Titaniumthunder/MAC-Attack/docs/README.md

# docs

| Item | What it is |
|---|---|
| `Model/` | **Everything about the machine-learning model**, numbered in the order it happened. Start with `Model/README.md` (reading order and the story from 01 onward); the current model is `13_modelV2_bearing_status_and_health.pdf`, and `14_modelV2_review_session.pdf` reviews it |
| `Machine_Guardian_Project_Brief.pdf` | the original project proposal |
| `log.md` | the project log: decisions, hardware builds and board tests, in order |
| `systolic_dataflow.html` | animated view of data moving through the 8 × 8 systolic array |
