Titaniumthunder/MAC-Attack/Alex/README.md

# Alex

Owner of:
- RTL / architecture
- Board bring-up (ZedBoard)
- Chip interface spec
- Board results

Put personal notes, scratch work and results here. Shared source goes in the design folders,
`mac_attack_accel/` (design 1) and `mac_attack_accel_MLP/` (design 2). The step 14 staging files that were in
`Alex/step14/` are in `archive/Alex/step14/`.
