Titaniumthunder/MAC-Attack/James/README.md

# James

Owner of:
- Verification (Python golden model)
- ML track (DCASE data, training, INT8/INT4 quantization)
- Equation proofs

Put personal notes, scratch work and results here. Shared source goes in `mac_attack_accel/`.
Datasets and large weight files go to Google Drive, not git.
