Titaniumthunder/MAC-Attack/Marco/README.md

# Marco

Owner of:
- Physical design (OpenLane / SKY130)
- Fabrication research
- Power measurement

Put personal notes, scratch work and results here. Shared source goes in `mac_attack_accel/`.
