Titaniumthunder/MAC-Attack/mac_attack_accel/zed/mac_zed_project/mac_zed.runs/impl_1/.init_design.begin.rst

<?xml version="1.0"?>
<ProcessHandle Version="1" Minor="0">
    <Process Command=".planAhead." Owner="alexsalamati" Host="ALEXSALAMAT56FC" Pid="10828">
    </Process>
</ProcessHandle>
