Titaniumthunder/MAC-Attack/mac_attack_accel/zed/mac_zed_project/mac_zed.runs/system_auto_pc_0_synth_1/.vivado.begin.rst

<?xml version="1.0"?>
<ProcessHandle Version="1" Minor="0">
    <Process Command="vivado.bat" Owner="User" Host="ALEX" Pid="52168" HostCore="24" HostMemory="033519468544">
    </Process>
</ProcessHandle>
