Titaniumthunder/MAC-Attack/mac_attack_accel/zed/mac_zed_project/mac_zed.runs/system_mac_0_synth_1/.vivado.begin.rst

<?xml version="1.0"?>
<ProcessHandle Version="1" Minor="0">
    <Process Command="vivado.bat" Owner="alexsalamati" Host="ALEXSALAMAT56FC" Pid="5024" HostCore="16" HostMemory="034353119232">
    </Process>
</ProcessHandle>
