Titaniumthunder/MAC-Attack/mac_attack_accel_MLP/zed/mac_zed_project/mac_zed.runs/impl_1/.vivado.begin.rst

<?xml version="1.0"?>
<ProcessHandle Version="1" Minor="0">
    <Process Command="vivado.bat" Owner="alexsalamati" Host="ALEXSALAMAT56FC" Pid="1852" HostCore="16" HostMemory="034353119232">
    </Process>
</ProcessHandle>
