Titaniumthunder/MAC-Attack/docs/Model/13_modelV2_bearing_status_and_health.pdf

# Machine Guardian modelV2: bearing status and health on the MAC accelerator

A vibration sensor on a motor bearing is measured for 1.6 s at a time. A host processor turns each measurement into 13 numbers that say how far the bearing has moved from its own healthy start. A small neural network on the chip (the INT8 systolic-array MLP accelerator) turns those numbers into a status (healthy, developing or faulty) and a health value. The host combines them into one of four levels (Normal, Anomaly, Warning, Failing) and a health percentage.

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
