Titaniumthunder/MAC-Attack/model/report/figures/decision_speed.png

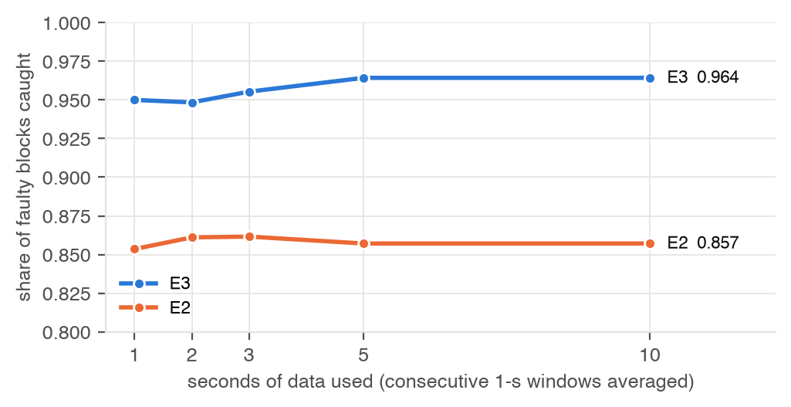
model/report/figures/decision_speed.png
