Titaniumthunder/MAC-Attack/model/report/figures/health_index.png

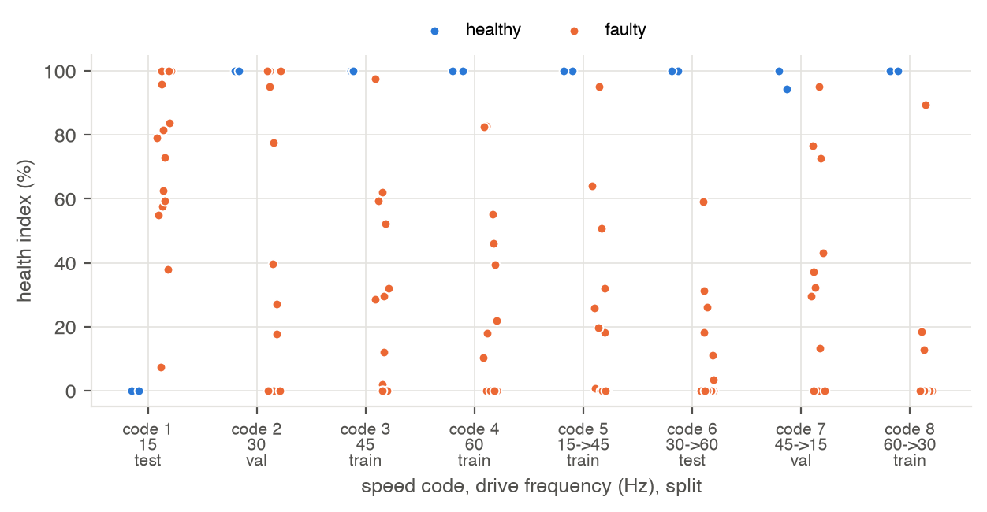
model/report/figures/health_index.png
