Titaniumthunder/MAC-Attack/model/report/figures/scores_E3.png

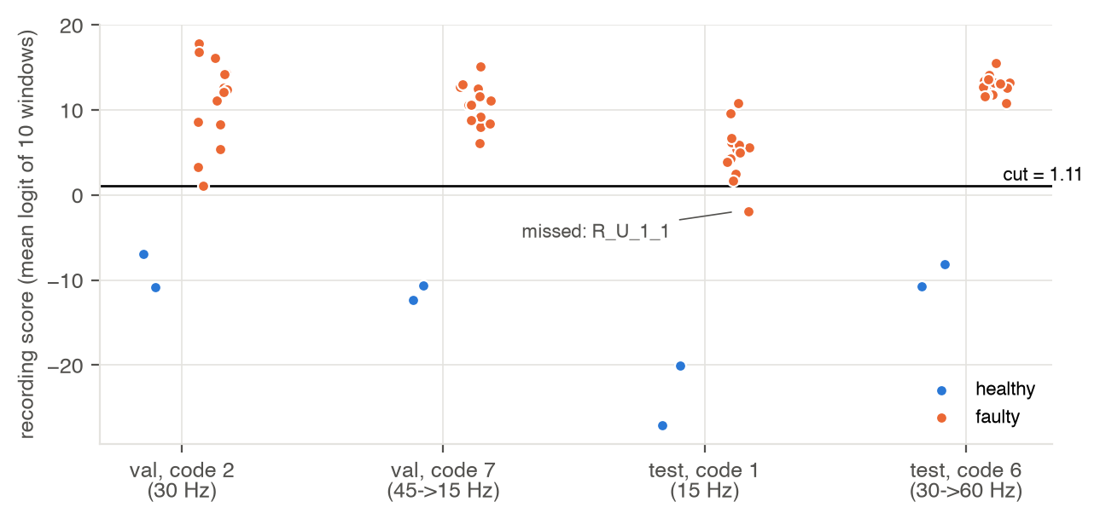
model/report/figures/scores_E3.png
