Titaniumthunder/MAC-Attack/model/report/figures/training_E3_s42.png

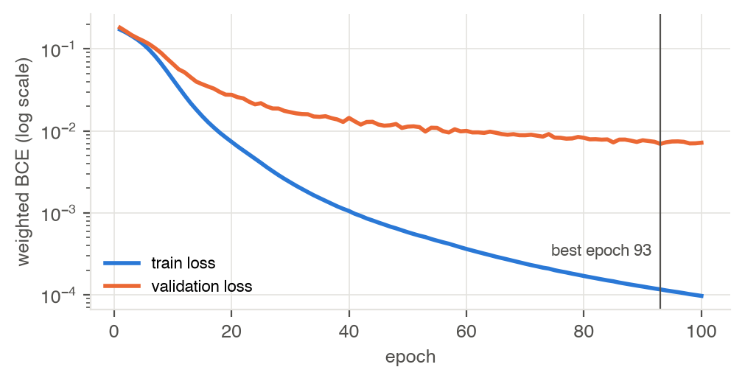
model/report/figures/training_E3_s42.png
