Titaniumthunder/MAC-Attack/model/results/B01/figures/B01_overview.png

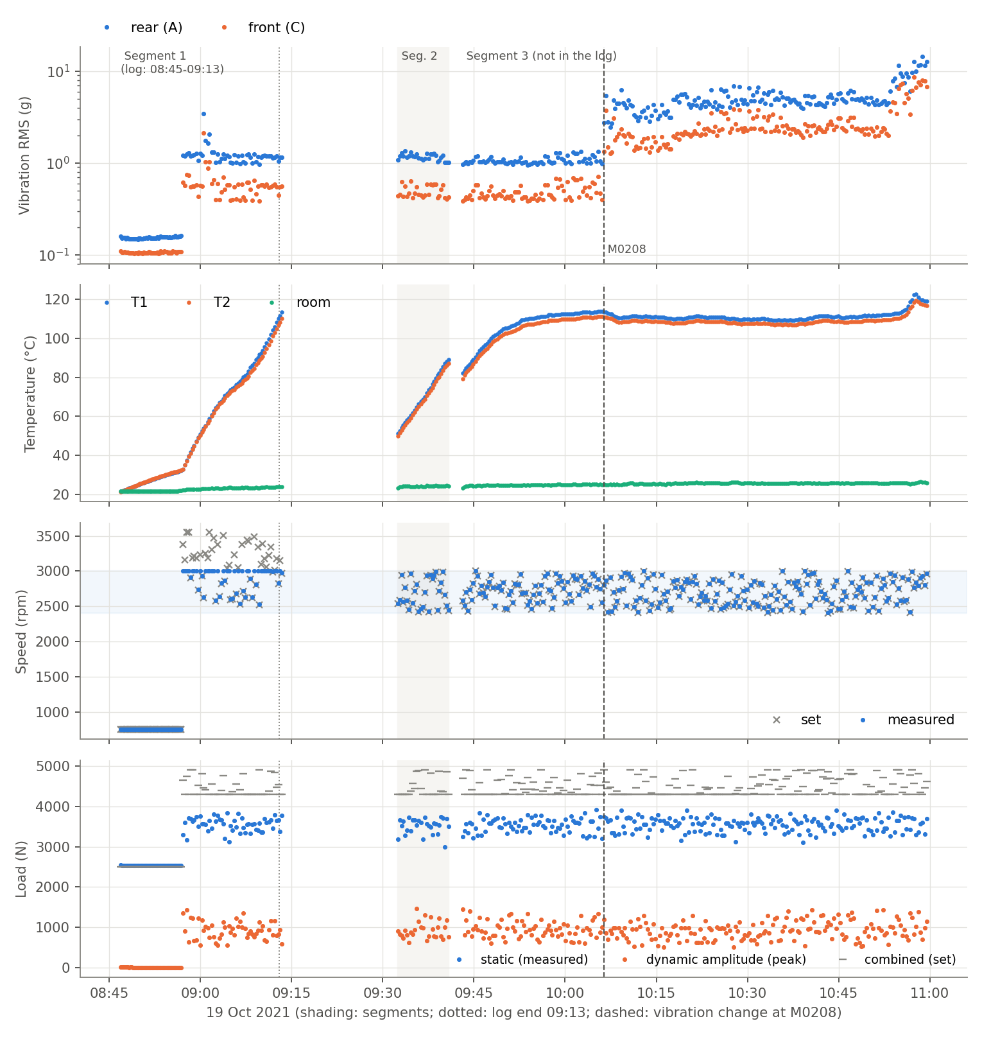
model/results/B01/figures/B01_overview.png
