Titaniumthunder/MAC-Attack/model/results/paderborn/B01/figures/B01_overview.png

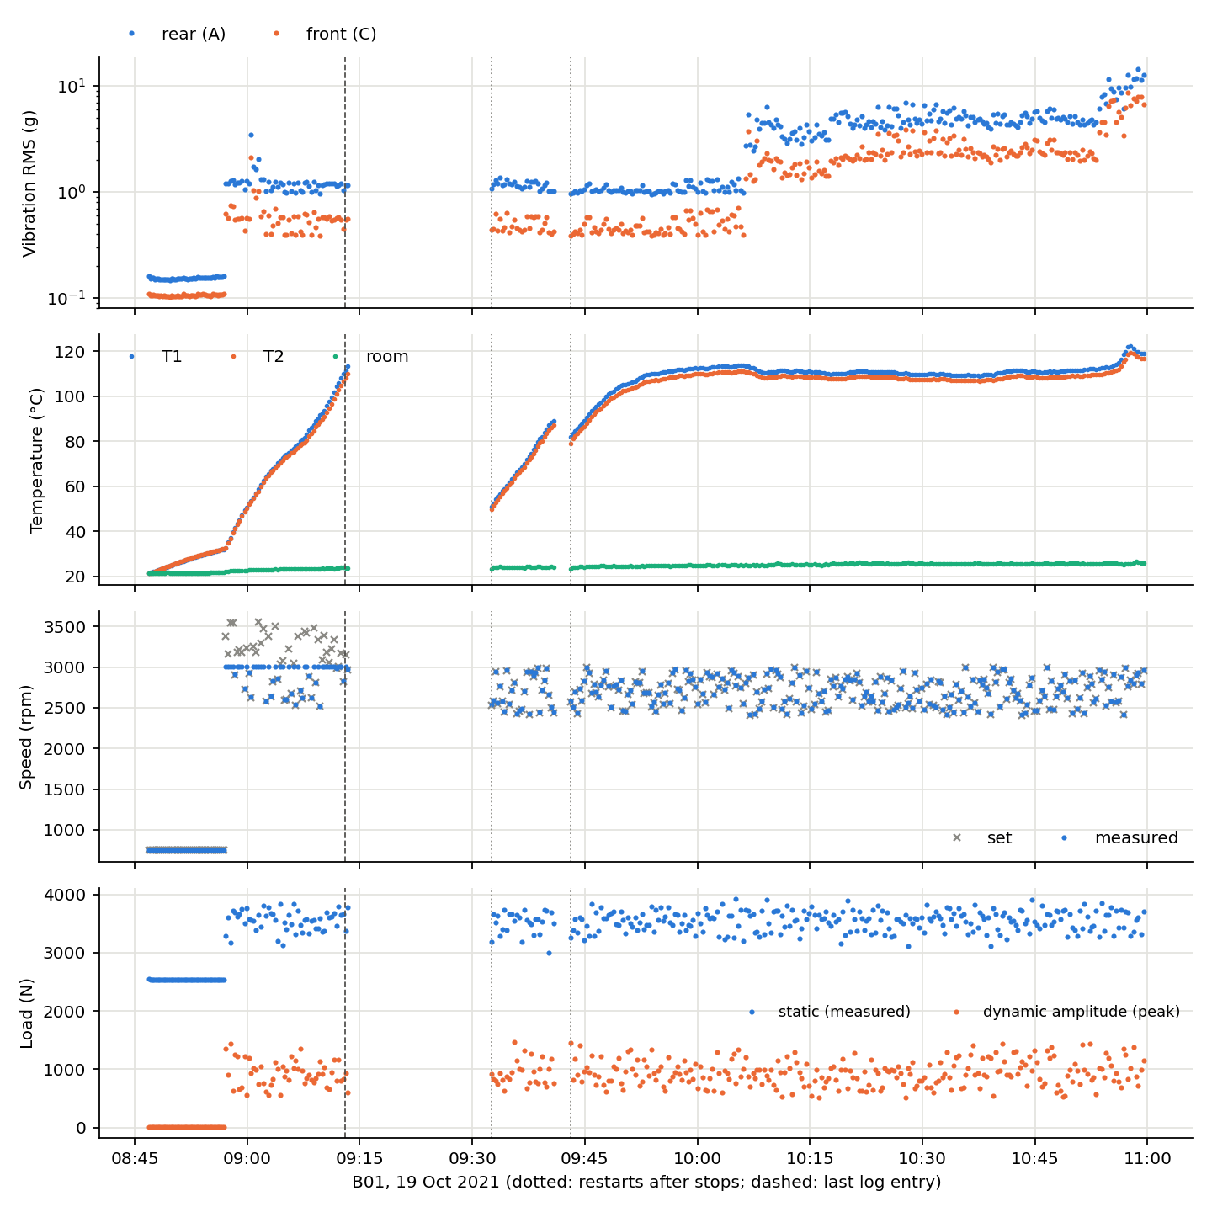
model/results/paderborn/B01/figures/B01_overview.png
