Titaniumthunder/MAC-Attack/model/results/paderborn/B02/figures/B02_overview.png

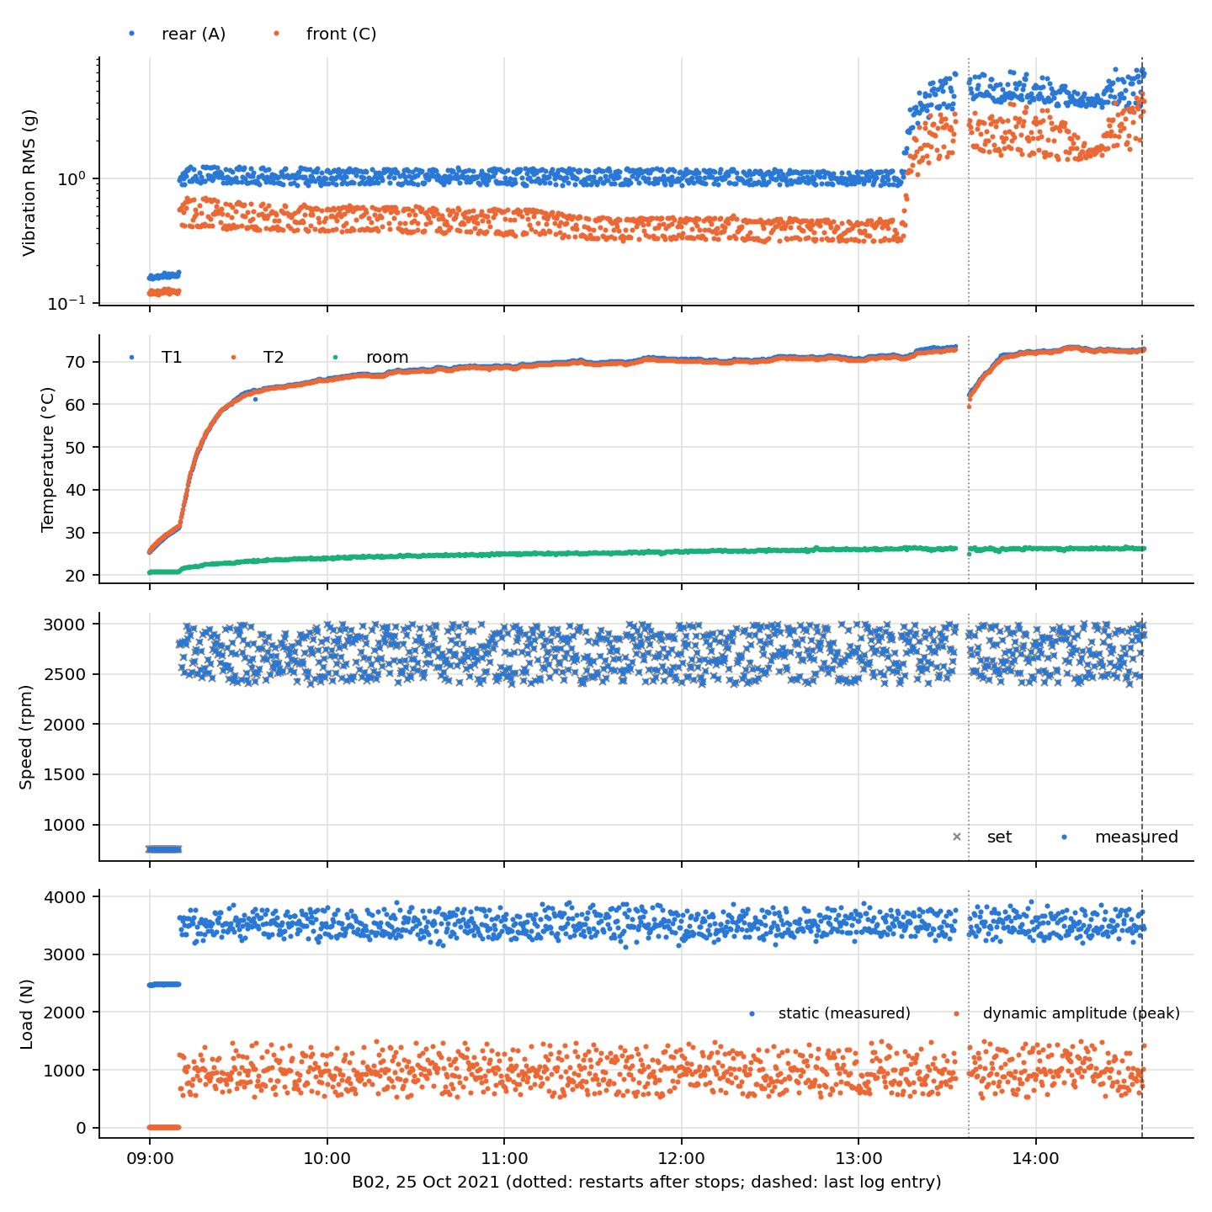
model/results/paderborn/B02/figures/B02_overview.png
