Titaniumthunder/MAC-Attack/model/results/paderborn/B04/figures/B04_overview.png

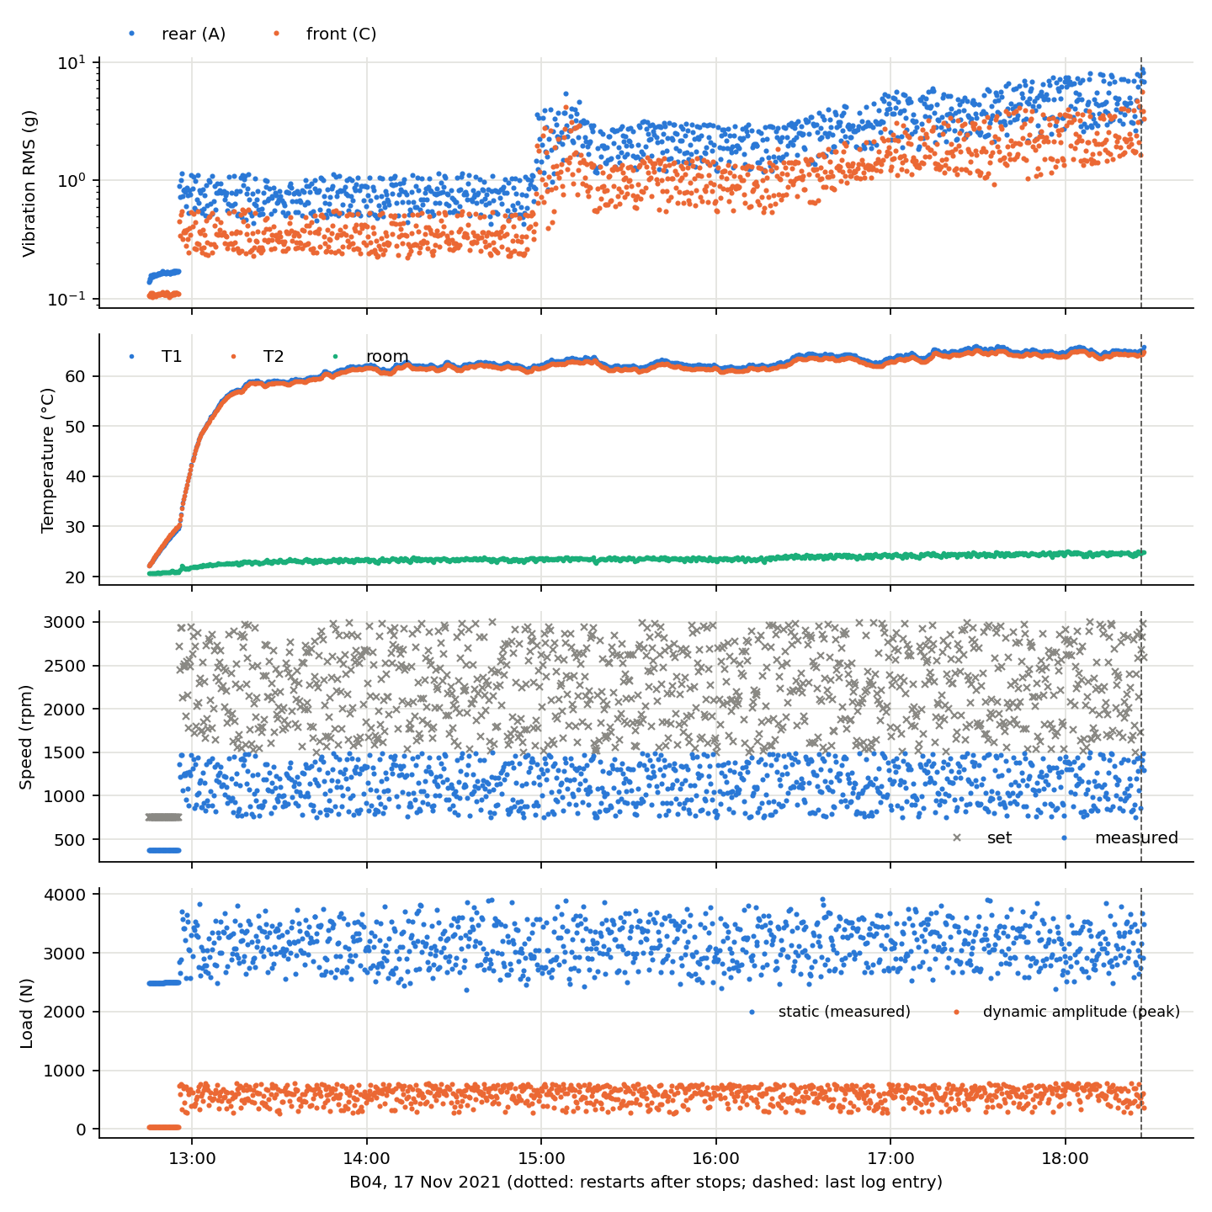
model/results/paderborn/B04/figures/B04_overview.png
