Titaniumthunder/MAC-Attack/model/results/paderborn/B08/figures/B08_overview.png

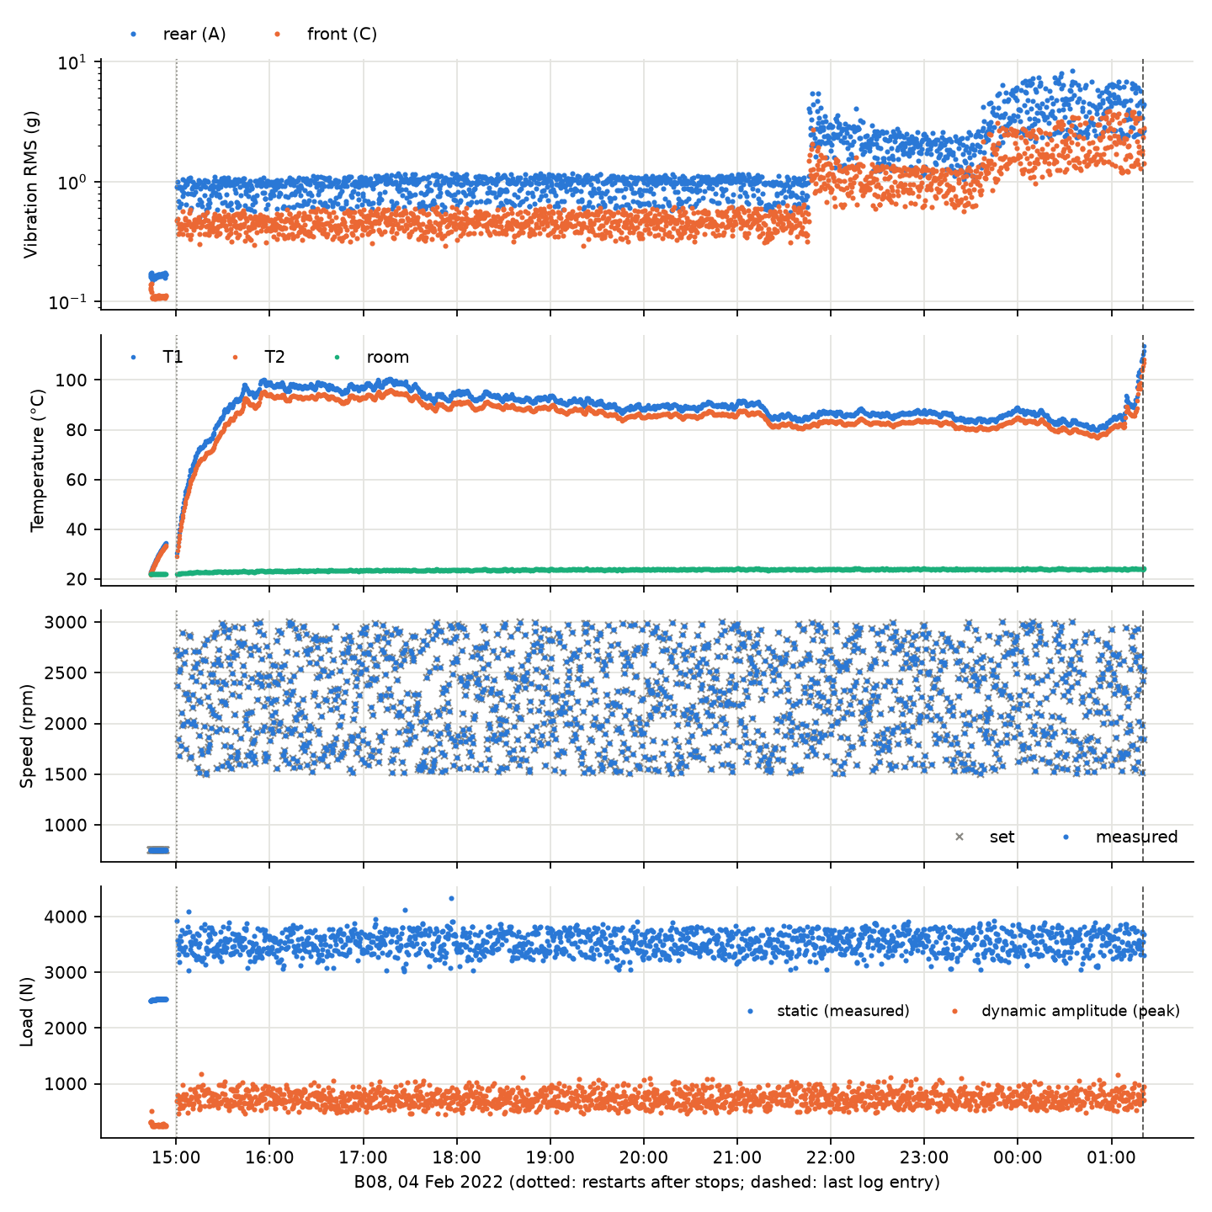
model/results/paderborn/B08/figures/B08_overview.png
