Titaniumthunder/MAC-Attack/model/results/paderborn/B09/figures/B09_overview.png

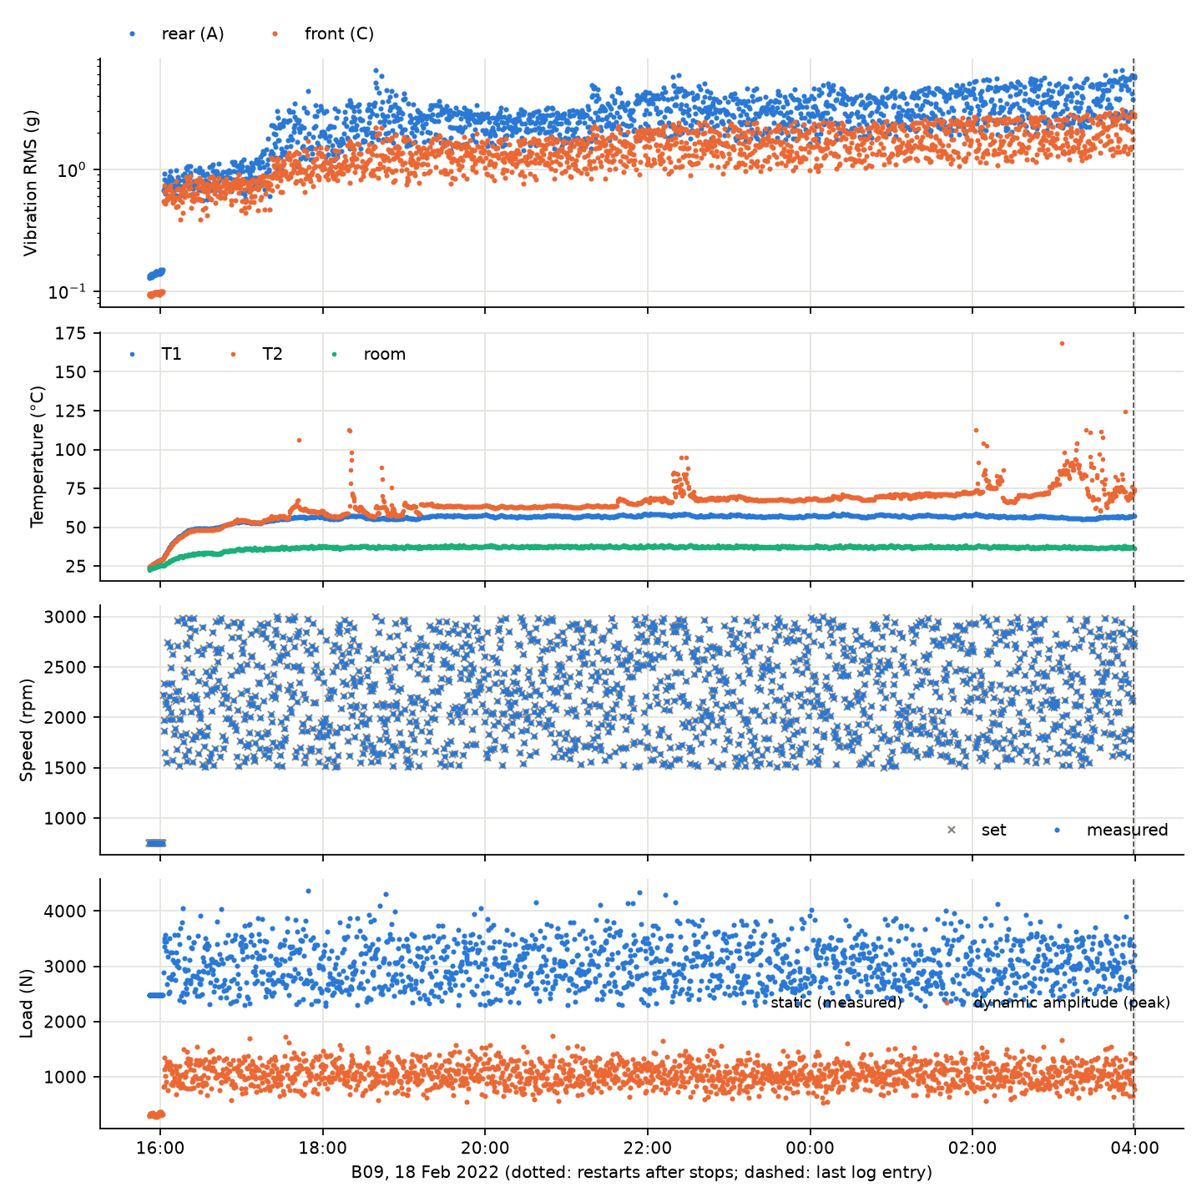
model/results/paderborn/B09/figures/B09_overview.png
