Titaniumthunder/MAC-Attack/model/results/paderborn/B11/figures/B11_overview.png

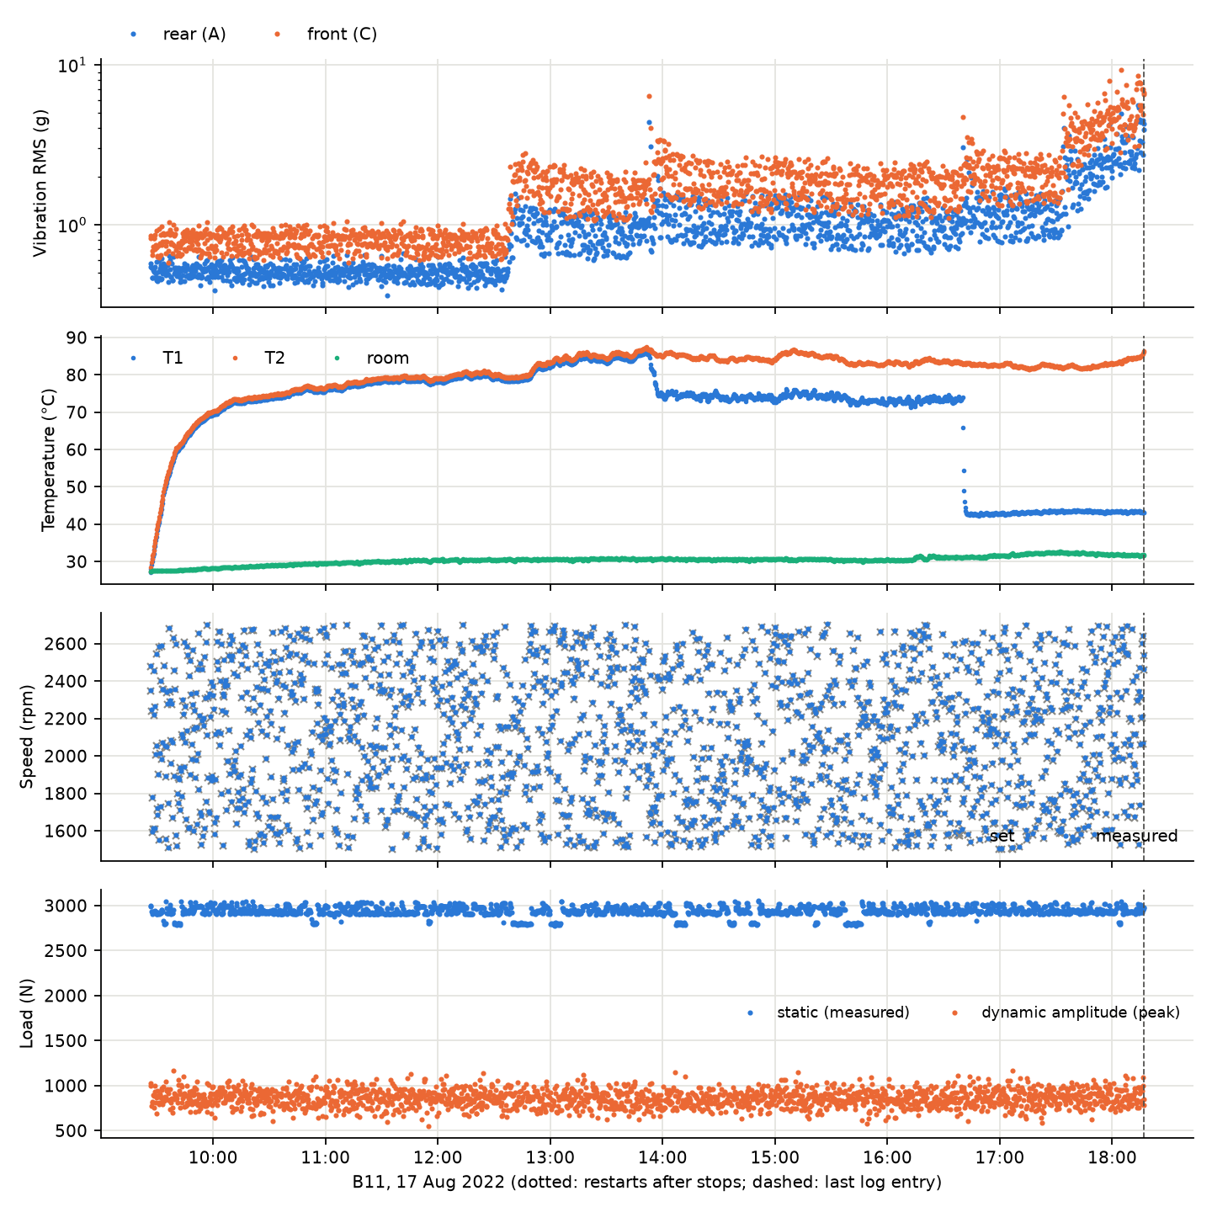
model/results/paderborn/B11/figures/B11_overview.png
