Titaniumthunder/MAC-Attack/model/results/paderborn/B12/figures/B12_overview.png

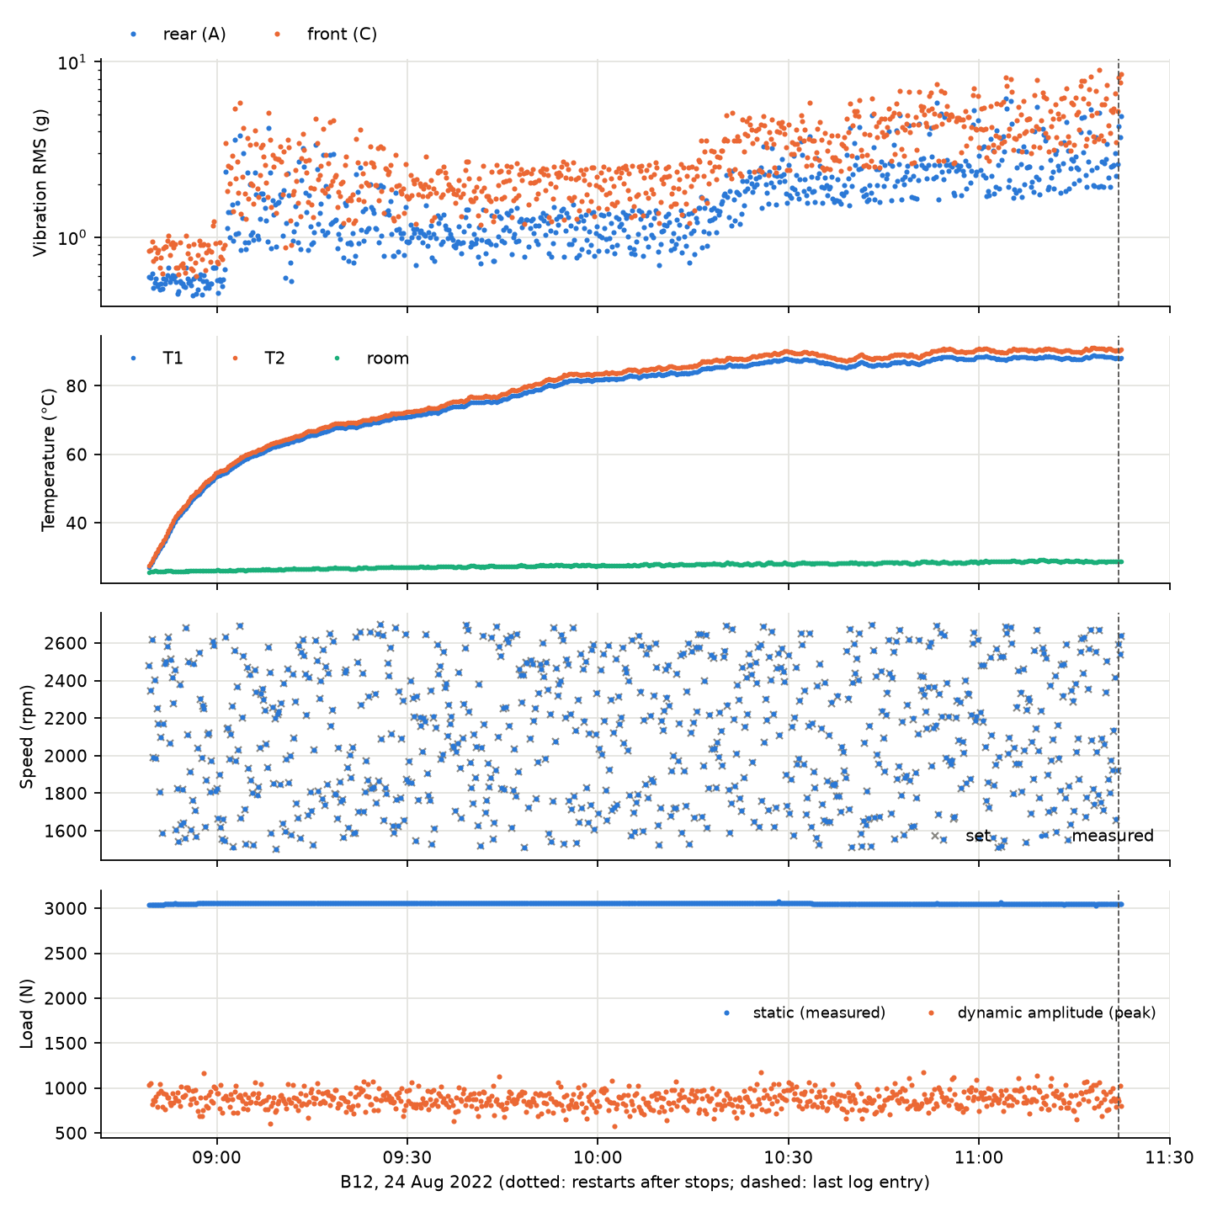
model/results/paderborn/B12/figures/B12_overview.png
