Titaniumthunder/MAC-Attack/mac_attack_accel/zed/mac_zed_project/mac_zed.runs/impl_1/usage_statistics_webtalk.html

### Device Usage Page (usage_statistics_webtalk.html)

This HTML page displays the device usage statistics that will be sent to Xilinx.
To see the actual file transmitted to Xilinx, please click here.

software_version_and_target_device
beta | FALSE | build_version | 2552052
date_generated | Tue Oct 20 12:20:01 2026 | os_platform | WIN64
product_version | Vivado v2019.1 (64-bit) | project_id | 204b8265c2ad4e69bc236f9b49018907
project_iteration | 3 | random_id | 4de1109a92a0531e92bb4dc50cde91a0
registration_id | 213588686_0_0_662 | route_design | TRUE
target_device | xc7z020 | target_family | zynq
target_package | clg484 | target_speed | -1
tool_flow | Vivado

user_environment
cpu_name | Apple Silicon | cpu_speed | 3200 MHz
os_name | Windows Server 2016 or Windows 10 | os_release | major release (build 9200)
system_ram | 34.000 GB | total_processors | 1

vivado_usage

gui_handlers
basedialog_cancel=6 | basedialog_ok=29 | basedialog_yes=7 | clkconfigtreetablepanel_clk_config_tree_table=20
cmdmsgdialog_ok=7 | commandsinput_type_tcl_command_here=4 | expruntreepanel_exp_run_tree_table=1 | filesetpanel_file_set_panel_tree=27
flownavigatortreepanel_flow_navigator_tree=17 | gettingstartedview_open_project=1 | mainmenumgr_checkpoint=4 | mainmenumgr_constraints=3
mainmenumgr_export=4 | mainmenumgr_file=10 | mainmenumgr_import=2 | mainmenumgr_ip=5
mainmenumgr_project=5 | mainmenumgr_text_editor=4 | mainmenumgr_tools=2 | navigabletimingreporttab_timing_report_navigation_tree=3
newexporthardwaredialog_include_bitstream=2 | numjobschooser_number_of_jobs=4 | pacommandnames_export_hardware=2 | pacommandnames_launch_hardware=2
pacommandnames_simulation_run_behavioral=1 | pacommandnames_zoom_fit=1 | paviews_device=1 | paviews_project_summary=13
planaheadtab_refresh_changed_modules=6 | projecttab_close_design=1 | rdicommands_run_script=1 | rsbapplyautomationbar_run_connection_automation=1
saveprojectutils_save=4 | syntheticagettingstartedview_recent_projects=6 | tclconsoleview_tcl_console_code_editor=9

java_command_handlers
customizersbblock=10 | newexporthardware=2 | newlaunchhardware=2 | openproject=1
runbitgen=3 | runimplementation=9 | runscript=1 | runsynthesis=3
simulationrun=1 | viewtaskimplementation=8 | zoomfit=1

other_data

guimode=6

project_data
constraintsetcount=0 | core_container=false | currentimplrun=impl_1 | currentsynthesisrun=synth_1
default_library=xil_defaultlib | designmode=RTL | export_simulation_activehdl=0 | export_simulation_ies=0
export_simulation_modelsim=0 | export_simulation_questa=0 | export_simulation_riviera=0 | export_simulation_vcs=0
export_simulation_xsim=0 | implstrategy=Performance_ExplorePostRoutePhysOpt | launch_simulation_activehdl=0 | launch_simulation_ies=0
launch_simulation_modelsim=0 | launch_simulation_questa=0 | launch_simulation_riviera=0 | launch_simulation_vcs=0
launch_simulation_xsim=1 | simulator_language=Mixed | srcsetcount=13 | synthesisstrategy=Vivado Synthesis Defaults
target_language=Verilog | target_simulator=XSim | totalimplruns=2 | totalsynthesisruns=2

unisim_transformation

post_unisim_transformation
bibuf=130 | bufg=1 | carry4=92 | dsp48e1=64
fdre=3086 | fdse=54 | gnd=108 | lut1=167
lut2=334 | lut3=375 | lut4=129 | lut5=174
lut6=335 | muxf7=22 | ps7=1 | ramb18e1=1
ramb36e1=4 | srl16e=19 | srlc32e=47 | vcc=114

pre_unisim_transformation
bibuf=130 | bufg=1 | carry4=92 | dsp48e1=64
fdre=3086 | fdse=54 | gnd=108 | lut1=167
lut2=334 | lut3=375 | lut4=129 | lut5=174
lut6=335 | muxf7=22 | ps7=1 | ramb18e1=1
ramb36e1=4 | srl16e=19 | srlc32e=47 | vcc=114

phys_opt_design_post_place

command_line_options
-aggressive_hold_fix=default::[not_specified] | -bram_register_opt=default::[not_specified] | -clock_opt=default::[not_specified] | -critical_cell_opt=default::[not_specified]
-critical_pin_opt=default::[not_specified] | -directive=Explore | -dsp_register_opt=default::[not_specified] | -effort_level=default::[not_specified]
-fanout_opt=default::[not_specified] | -hold_fix=default::[not_specified] | -insert_negative_edge_ffs=default::[not_specified] | -multi_clock_opt=default::[not_specified]
-placement_opt=default::[not_specified] | -restruct_opt=default::[not_specified] | -retime=default::[not_specified] | -rewire=default::[not_specified]
-shift_register_opt=default::[not_specified] | -uram_register_opt=default::[not_specified] | -verbose=default::[not_specified] | -vhfn=default::[not_specified]

usage
postths=0.000000 | posttns=-0.115284 | postwhs=0.000000 | postwns=-0.057642
preths=0.000000 | pretns=-1.633059 | prewhs=0.000000 | prewns=-0.271642

phys_opt_design_post_route

command_line_options
-aggressive_hold_fix=default::[not_specified] | -bram_register_opt=default::[not_specified] | -clock_opt=default::[not_specified] | -critical_cell_opt=default::[not_specified]
-critical_pin_opt=default::[not_specified] | -directive=Explore | -dsp_register_opt=default::[not_specified] | -effort_level=default::[not_specified]
-fanout_opt=default::[not_specified] | -hold_fix=default::[not_specified] | -insert_negative_edge_ffs=default::[not_specified] | -multi_clock_opt=default::[not_specified]
-placement_opt=default::[not_specified] | -restruct_opt=default::[not_specified] | -retime=default::[not_specified] | -rewire=default::[not_specified]
-shift_register_opt=default::[not_specified] | -uram_register_opt=default::[not_specified] | -verbose=default::[not_specified] | -vhfn=default::[not_specified]

usage
postths=0.000000 | posttns=0.000000 | postwhs=0.019446 | postwns=0.007959
preths=0.000000 | pretns=-0.005431 | prewhs=0.019446 | prewns=-0.002716

power_opt_design

command_line_options_spo
-cell_types=default::all | -clocks=default::[not_specified] | -exclude_cells=default::[not_specified] | -include_cells=default::[not_specified]

usage
bram_ports_augmented=2 | bram_ports_newly_gated=5 | bram_ports_total=10 | flow_state=default
slice_registers_augmented=0 | slice_registers_newly_gated=0 | slice_registers_total=2997 | srls_augmented=0
srls_newly_gated=0 | srls_total=64

ip_statistics

IP_Integrator/1
bdsource=USER | core_container=NA | da_clkrst_cnt=1 | da_ps7_cnt=1
iptotal=1 | maxhierdepth=0 | numblks=6 | numhdlrefblks=1
numhierblks=2 | numhlsblks=0 | numnonxlnxblks=0 | numpkgbdblks=0
numreposblks=4 | numsysgenblks=0 | synth_mode=OOC_per_IP | x_iplanguage=VERILOG
x_iplibrary=BlockDiagram | x_ipname=system | x_ipvendor=xilinx.com | x_ipversion=1.00.a

axi_protocol_converter_v2_1_19_axi_protocol_converter/1
c_axi_addr_width=32 | c_axi_aruser_width=1 | c_axi_awuser_width=1 | c_axi_buser_width=1
c_axi_data_width=32 | c_axi_id_width=12 | c_axi_ruser_width=1 | c_axi_supports_read=1
c_axi_supports_user_signals=0 | c_axi_supports_write=1 | c_axi_wuser_width=1 | c_family=zynq
c_ignore_id=0 | c_m_axi_protocol=2 | c_s_axi_protocol=1 | c_translation_mode=2
core_container=NA | iptotal=1 | x_ipcorerevision=19 | x_iplanguage=VERILOG
x_iplibrary=ip | x_ipname=axi_protocol_converter | x_ipproduct=Vivado 2019.1 | x_ipsimlanguage=MIXED
x_ipvendor=xilinx.com | x_ipversion=2.1

mac_axi/1
core_clk=0 | core_container=NA | exact_acc=1 | hread_reg=1
iptotal=1 | maxd=64 | mem_reg=2 | p=8
pe_prim=1 | pipe=2 | x_ipcorerevision=1 | x_iplanguage=VERILOG
x_iplibrary=module_ref | x_ipname=mac_axi | x_ipproduct=Vivado 2019.1 | x_ipsimlanguage=MIXED
x_ipvendor=xilinx.com | x_ipversion=1.0

proc_sys_reset/1
c_aux_reset_high=0 | c_aux_rst_width=4 | c_ext_reset_high=0 | c_ext_rst_width=4
c_family=zynq | c_num_bus_rst=1 | c_num_interconnect_aresetn=1 | c_num_perp_aresetn=1
c_num_perp_rst=1 | core_container=NA | iptotal=1 | x_ipcorerevision=13
x_iplanguage=VERILOG | x_iplibrary=ip | x_ipname=proc_sys_reset | x_ipproduct=Vivado 2019.1
x_ipsimlanguage=MIXED | x_ipvendor=xilinx.com | x_ipversion=5.0

processing_system7_v5.5_user_configuration/1
core_container=NA | iptotal=1 | pcw_apu_clk_ratio_enable=6:2:1 | pcw_apu_peripheral_freqmhz=666.666667
pcw_armpll_ctrl_fbdiv=40 | pcw_can0_grp_clk_enable=0 | pcw_can0_peripheral_clksrc=External | pcw_can0_peripheral_enable=0
pcw_can0_peripheral_freqmhz=-1 | pcw_can1_grp_clk_enable=0 | pcw_can1_peripheral_clksrc=External | pcw_can1_peripheral_enable=0
pcw_can1_peripheral_freqmhz=-1 | pcw_can_peripheral_clksrc=IO PLL | pcw_can_peripheral_freqmhz=100 | pcw_cpu_cpu_pll_freqmhz=1333.333
pcw_cpu_peripheral_clksrc=ARM PLL | pcw_crystal_peripheral_freqmhz=33.333333 | pcw_dci_peripheral_clksrc=DDR PLL | pcw_dci_peripheral_freqmhz=10.159
pcw_ddr_ddr_pll_freqmhz=1066.667 | pcw_ddr_hpr_to_critical_priority_level=15 | pcw_ddr_hprlpr_queue_partition=HPR(0)/LPR(32) | pcw_ddr_lpr_to_critical_priority_level=2
pcw_ddr_peripheral_clksrc=DDR PLL | pcw_ddr_port0_hpr_enable=0 | pcw_ddr_port1_hpr_enable=0 | pcw_ddr_port2_hpr_enable=0
pcw_ddr_port3_hpr_enable=0 | pcw_ddr_write_to_critical_priority_level=2 | pcw_ddrpll_ctrl_fbdiv=32 | pcw_enet0_enet0_io=MIO 16 .. 27
pcw_enet0_grp_mdio_enable=1 | pcw_enet0_peripheral_clksrc=IO PLL | pcw_enet0_peripheral_enable=1 | pcw_enet0_peripheral_freqmhz=1000 Mbps
pcw_enet0_reset_enable=0 | pcw_enet1_grp_mdio_enable=0 | pcw_enet1_peripheral_clksrc=IO PLL | pcw_enet1_peripheral_enable=0
pcw_enet1_peripheral_freqmhz=1000 Mbps | pcw_enet1_reset_enable=0 | pcw_enet_reset_polarity=Active Low | pcw_fclk0_peripheral_clksrc=IO PLL
pcw_fclk1_peripheral_clksrc=IO PLL | pcw_fclk2_peripheral_clksrc=IO PLL | pcw_fclk3_peripheral_clksrc=IO PLL | pcw_fpga0_peripheral_freqmhz=250
pcw_fpga1_peripheral_freqmhz=150.000000 | pcw_fpga2_peripheral_freqmhz=50 | pcw_fpga3_peripheral_freqmhz=50 | pcw_fpga_fclk0_enable=1
pcw_fpga_fclk1_enable=0 | pcw_fpga_fclk2_enable=0 | pcw_fpga_fclk3_enable=0 | pcw_ftm_cti_in0=DISABLED
pcw_ftm_cti_in1=DISABLED | pcw_ftm_cti_in2=DISABLED | pcw_ftm_cti_in3=DISABLED | pcw_ftm_cti_out0=DISABLED
pcw_ftm_cti_out1=DISABLED | pcw_ftm_cti_out2=DISABLED | pcw_ftm_cti_out3=DISABLED | pcw_gpio_emio_gpio_enable=0
pcw_gpio_mio_gpio_enable=1 | pcw_gpio_mio_gpio_io=MIO | pcw_gpio_peripheral_enable=0 | pcw_i2c0_grp_int_enable=0
pcw_i2c0_peripheral_enable=0 | pcw_i2c0_reset_enable=0 | pcw_i2c1_grp_int_enable=0 | pcw_i2c1_peripheral_enable=0
pcw_i2c1_reset_enable=0 | pcw_i2c_reset_polarity=Active Low | pcw_io_io_pll_freqmhz=1000.000 | pcw_iopll_ctrl_fbdiv=30
pcw_irq_f2p_mode=DIRECT | pcw_m_axi_gp0_freqmhz=250 | pcw_m_axi_gp1_freqmhz=10 | pcw_nand_cycles_t_ar=1
pcw_nand_cycles_t_clr=1 | pcw_nand_cycles_t_rc=11 | pcw_nand_cycles_t_rea=1 | pcw_nand_cycles_t_rr=1
pcw_nand_cycles_t_wc=11 | pcw_nand_cycles_t_wp=1 | pcw_nand_grp_d8_enable=0 | pcw_nand_peripheral_enable=0
pcw_nor_cs0_t_ceoe=1 | pcw_nor_cs0_t_pc=1 | pcw_nor_cs0_t_rc=11 | pcw_nor_cs0_t_tr=1
pcw_nor_cs0_t_wc=11 | pcw_nor_cs0_t_wp=1 | pcw_nor_cs0_we_time=0 | pcw_nor_cs1_t_ceoe=1
pcw_nor_cs1_t_pc=1 | pcw_nor_cs1_t_rc=11 | pcw_nor_cs1_t_tr=1 | pcw_nor_cs1_t_wc=11
pcw_nor_cs1_t_wp=1 | pcw_nor_cs1_we_time=0 | pcw_nor_grp_a25_enable=0 | pcw_nor_grp_cs0_enable=0
pcw_nor_grp_cs1_enable=0 | pcw_nor_grp_sram_cs0_enable=0 | pcw_nor_grp_sram_cs1_enable=0 | pcw_nor_grp_sram_int_enable=0
pcw_nor_peripheral_enable=0 | pcw_nor_sram_cs0_t_ceoe=1 | pcw_nor_sram_cs0_t_pc=1 | pcw_nor_sram_cs0_t_rc=11
pcw_nor_sram_cs0_t_tr=1 | pcw_nor_sram_cs0_t_wc=11 | pcw_nor_sram_cs0_t_wp=1 | pcw_nor_sram_cs0_we_time=0
pcw_nor_sram_cs1_t_ceoe=1 | pcw_nor_sram_cs1_t_pc=1 | pcw_nor_sram_cs1_t_rc=11 | pcw_nor_sram_cs1_t_tr=1
pcw_nor_sram_cs1_t_wc=11 | pcw_nor_sram_cs1_t_wp=1 | pcw_nor_sram_cs1_we_time=0 | pcw_override_basic_clock=0
pcw_pcap_peripheral_clksrc=IO PLL | pcw_pcap_peripheral_freqmhz=200 | pcw_pjtag_peripheral_enable=0 | pcw_preset_bank0_voltage=LVCMOS 3.3V
pcw_preset_bank1_voltage=LVCMOS 1.8V | pcw_qspi_grp_fbclk_enable=0 | pcw_qspi_grp_io1_enable=0 | pcw_qspi_grp_single_ss_enable=1
pcw_qspi_grp_single_ss_io=MIO 1 .. 6 | pcw_qspi_grp_ss1_enable=0 | pcw_qspi_internal_highaddress=0xFCFFFFFF | pcw_qspi_peripheral_clksrc=IO PLL
pcw_qspi_peripheral_enable=1 | pcw_qspi_peripheral_freqmhz=200 | pcw_qspi_qspi_io=MIO 1 .. 6 | pcw_s_axi_acp_freqmhz=10
pcw_s_axi_gp0_freqmhz=10 | pcw_s_axi_gp1_freqmhz=10 | pcw_s_axi_hp0_data_width=64 | pcw_s_axi_hp0_freqmhz=10
pcw_s_axi_hp1_data_width=64 | pcw_s_axi_hp1_freqmhz=10 | pcw_s_axi_hp2_data_width=64 | pcw_s_axi_hp2_freqmhz=10
pcw_s_axi_hp3_data_width=64 | pcw_s_axi_hp3_freqmhz=10 | pcw_sd0_grp_cd_enable=1 | pcw_sd0_grp_cd_io=MIO 47
pcw_sd0_grp_pow_enable=0 | pcw_sd0_grp_wp_enable=1 | pcw_sd0_grp_wp_io=MIO 46 | pcw_sd0_peripheral_enable=1
pcw_sd0_sd0_io=MIO 40 .. 45 | pcw_sd1_grp_cd_enable=0 | pcw_sd1_grp_pow_enable=0 | pcw_sd1_grp_wp_enable=0
pcw_sd1_peripheral_enable=0 | pcw_sdio_peripheral_clksrc=IO PLL | pcw_sdio_peripheral_freqmhz=50 | pcw_single_qspi_data_mode=x4
pcw_smc_peripheral_clksrc=IO PLL | pcw_smc_peripheral_freqmhz=100 | pcw_spi0_grp_ss0_enable=0 | pcw_spi0_grp_ss1_enable=0
pcw_spi0_grp_ss2_enable=0 | pcw_spi0_peripheral_enable=0 | pcw_spi1_grp_ss0_enable=0 | pcw_spi1_grp_ss1_enable=0
pcw_spi1_grp_ss2_enable=0 | pcw_spi1_peripheral_enable=0 | pcw_spi_peripheral_clksrc=IO PLL | pcw_spi_peripheral_freqmhz=166.666666
pcw_tpiu_peripheral_clksrc=External | pcw_tpiu_peripheral_freqmhz=200 | pcw_trace_grp_16bit_enable=0 | pcw_trace_grp_2bit_enable=0
pcw_trace_grp_32bit_enable=0 | pcw_trace_grp_4bit_enable=0 | pcw_trace_grp_8bit_enable=0 | pcw_trace_peripheral_enable=0
pcw_ttc0_clk0_peripheral_clksrc=CPU_1X | pcw_ttc0_clk0_peripheral_freqmhz=133.333333 | pcw_ttc0_clk1_peripheral_clksrc=CPU_1X | pcw_ttc0_clk1_peripheral_freqmhz=133.333333
pcw_ttc0_clk2_peripheral_clksrc=CPU_1X | pcw_ttc0_clk2_peripheral_freqmhz=133.333333 | pcw_ttc0_peripheral_enable=1 | pcw_ttc0_ttc0_io=EMIO
pcw_ttc1_clk0_peripheral_clksrc=CPU_1X | pcw_ttc1_clk0_peripheral_freqmhz=133.333333 | pcw_ttc1_clk1_peripheral_clksrc=CPU_1X | pcw_ttc1_clk1_peripheral_freqmhz=133.333333
pcw_ttc1_clk2_peripheral_clksrc=CPU_1X | pcw_ttc1_clk2_peripheral_freqmhz=133.333333 | pcw_ttc1_peripheral_enable=0 | pcw_ttc_peripheral_freqmhz=50
pcw_uart0_baud_rate=115200 | pcw_uart0_grp_full_enable=0 | pcw_uart0_peripheral_enable=0 | pcw_uart1_baud_rate=115200
pcw_uart1_grp_full_enable=0 | pcw_uart1_peripheral_enable=1 | pcw_uart1_uart1_io=MIO 48 .. 49 | pcw_uart_peripheral_clksrc=IO PLL
pcw_uart_peripheral_freqmhz=50 | pcw_uiparam_ddr_adv_enable=0 | pcw_uiparam_ddr_al=0 | pcw_uiparam_ddr_bank_addr_count=3
pcw_uiparam_ddr_bl=8 | pcw_uiparam_ddr_board_delay0=0.41 | pcw_uiparam_ddr_board_delay1=0.411 | pcw_uiparam_ddr_board_delay2=0.341
pcw_uiparam_ddr_board_delay3=0.358 | pcw_uiparam_ddr_bus_width=32 Bit | pcw_uiparam_ddr_cl=7 | pcw_uiparam_ddr_clock_0_length_mm=0
pcw_uiparam_ddr_clock_0_package_length=61.0905 | pcw_uiparam_ddr_clock_0_propogation_delay=160 | pcw_uiparam_ddr_clock_1_length_mm=0 | pcw_uiparam_ddr_clock_1_package_length=61.0905
pcw_uiparam_ddr_clock_1_propogation_delay=160 | pcw_uiparam_ddr_clock_2_length_mm=0 | pcw_uiparam_ddr_clock_2_package_length=61.0905 | pcw_uiparam_ddr_clock_2_propogation_delay=160
pcw_uiparam_ddr_clock_3_length_mm=0 | pcw_uiparam_ddr_clock_3_package_length=61.0905 | pcw_uiparam_ddr_clock_3_propogation_delay=160 | pcw_uiparam_ddr_clock_stop_en=0
pcw_uiparam_ddr_col_addr_count=10 | pcw_uiparam_ddr_cwl=6 | pcw_uiparam_ddr_device_capacity=2048 MBits | pcw_uiparam_ddr_dq_0_length_mm=0
pcw_uiparam_ddr_dq_0_package_length=64.1705 | pcw_uiparam_ddr_dq_0_propogation_delay=160 | pcw_uiparam_ddr_dq_1_length_mm=0 | pcw_uiparam_ddr_dq_1_package_length=63.686
pcw_uiparam_ddr_dq_1_propogation_delay=160 | pcw_uiparam_ddr_dq_2_length_mm=0 | pcw_uiparam_ddr_dq_2_package_length=68.46 | pcw_uiparam_ddr_dq_2_propogation_delay=160
pcw_uiparam_ddr_dq_3_length_mm=0 | pcw_uiparam_ddr_dq_3_package_length=105.4895 | pcw_uiparam_ddr_dq_3_propogation_delay=160 | pcw_uiparam_ddr_dqs_0_length_mm=0
pcw_uiparam_ddr_dqs_0_package_length=68.4725 | pcw_uiparam_ddr_dqs_0_propogation_delay=160 | pcw_uiparam_ddr_dqs_1_length_mm=0 | pcw_uiparam_ddr_dqs_1_package_length=71.086
pcw_uiparam_ddr_dqs_1_propogation_delay=160 | pcw_uiparam_ddr_dqs_2_length_mm=0 | pcw_uiparam_ddr_dqs_2_package_length=66.794 | pcw_uiparam_ddr_dqs_2_propogation_delay=160
pcw_uiparam_ddr_dqs_3_length_mm=0 | pcw_uiparam_ddr_dqs_3_package_length=108.7385 | pcw_uiparam_ddr_dqs_3_propogation_delay=160 | pcw_uiparam_ddr_dqs_to_clk_delay_0=0.025
pcw_uiparam_ddr_dqs_to_clk_delay_1=0.028 | pcw_uiparam_ddr_dqs_to_clk_delay_2=0.001 | pcw_uiparam_ddr_dqs_to_clk_delay_3=0.001 | pcw_uiparam_ddr_dram_width=16 Bits
pcw_uiparam_ddr_ecc=Disabled | pcw_uiparam_ddr_enable=1 | pcw_uiparam_ddr_freq_mhz=533.333313 | pcw_uiparam_ddr_high_temp=Normal (0-85)
pcw_uiparam_ddr_memory_type=DDR 3 | pcw_uiparam_ddr_partno=MT41J128M16 HA-15E | pcw_uiparam_ddr_row_addr_count=14 | pcw_uiparam_ddr_speed_bin=DDR3_1066F
pcw_uiparam_ddr_t_faw=45.0 | pcw_uiparam_ddr_t_ras_min=36.0 | pcw_uiparam_ddr_t_rc=49.5 | pcw_uiparam_ddr_t_rcd=7
pcw_uiparam_ddr_t_rp=7 | pcw_uiparam_ddr_train_data_eye=1 | pcw_uiparam_ddr_train_read_gate=1 | pcw_uiparam_ddr_train_write_level=1
pcw_uiparam_ddr_use_internal_vref=1 | pcw_usb0_peripheral_enable=1 | pcw_usb0_peripheral_freqmhz=60 | pcw_usb0_reset_enable=0
pcw_usb0_usb0_io=MIO 28 .. 39 | pcw_usb1_peripheral_enable=0 | pcw_usb1_peripheral_freqmhz=60 | pcw_usb1_reset_enable=0
pcw_usb_reset_polarity=Active Low | pcw_use_cross_trigger=0 | pcw_use_m_axi_gp0=1 | pcw_use_m_axi_gp1=0
pcw_use_s_axi_acp=0 | pcw_use_s_axi_gp0=0 | pcw_use_s_axi_gp1=0 | pcw_use_s_axi_hp0=0
pcw_use_s_axi_hp1=0 | pcw_use_s_axi_hp2=0 | pcw_use_s_axi_hp3=0 | pcw_wdt_peripheral_clksrc=CPU_1X
pcw_wdt_peripheral_enable=0 | pcw_wdt_peripheral_freqmhz=133.333333

processing_system7_v5_5_processing_system7/1
c_dm_width=4 | c_dq_width=32 | c_dqs_width=4 | c_emio_gpio_width=64
c_en_emio_enet0=0 | c_en_emio_enet1=0 | c_en_emio_pjtag=0 | c_en_emio_trace=0
c_fclk_clk0_buf=TRUE | c_fclk_clk1_buf=FALSE | c_fclk_clk2_buf=FALSE | c_fclk_clk3_buf=FALSE
c_gp0_en_modifiable_txn=1 | c_gp1_en_modifiable_txn=1 | c_include_acp_trans_check=0 | c_include_trace_buffer=0
c_irq_f2p_mode=DIRECT | c_m_axi_gp0_enable_static_remap=0 | c_m_axi_gp0_id_width=12 | c_m_axi_gp0_thread_id_width=12
c_m_axi_gp1_enable_static_remap=0 | c_m_axi_gp1_id_width=12 | c_m_axi_gp1_thread_id_width=12 | c_mio_primitive=54
c_num_f2p_intr_inputs=1 | c_package_name=clg484 | c_ps7_si_rev=PRODUCTION | c_s_axi_acp_aruser_val=31
c_s_axi_acp_awuser_val=31 | c_s_axi_acp_id_width=3 | c_s_axi_gp0_id_width=6 | c_s_axi_gp1_id_width=6
c_s_axi_hp0_data_width=64 | c_s_axi_hp0_id_width=6 | c_s_axi_hp1_data_width=64 | c_s_axi_hp1_id_width=6
c_s_axi_hp2_data_width=64 | c_s_axi_hp2_id_width=6 | c_s_axi_hp3_data_width=64 | c_s_axi_hp3_id_width=6
c_trace_buffer_clock_delay=12 | c_trace_buffer_fifo_size=128 | c_trace_internal_width=2 | c_trace_pipeline_width=8
c_use_axi_nonsecure=0 | c_use_default_acp_user_val=0 | c_use_m_axi_gp0=1 | c_use_m_axi_gp1=0
c_use_s_axi_acp=0 | c_use_s_axi_gp0=0 | c_use_s_axi_gp1=0 | c_use_s_axi_hp0=0
c_use_s_axi_hp1=0 | c_use_s_axi_hp2=0 | c_use_s_axi_hp3=0 | core_container=NA
iptotal=1 | use_trace_data_edge_detector=0 | x_ipcorerevision=6 | x_iplanguage=VERILOG
x_iplibrary=ip | x_ipname=processing_system7 | x_ipproduct=Vivado 2019.1 | x_ipsimlanguage=MIXED
x_ipvendor=xilinx.com | x_ipversion=5.5

report_drc

command_line_options
-append=default::[not_specified] | -checks=default::[not_specified] | -fail_on=default::[not_specified] | -force=default::[not_specified]
-format=default::[not_specified] | -internal=default::[not_specified] | -internal_only=default::[not_specified] | -messages=default::[not_specified]
-name=default::[not_specified] | -no_waivers=default::[not_specified] | -return_string=default::[not_specified] | -ruledecks=default::[not_specified]
-upgrade_cw=default::[not_specified] | -waived=default::[not_specified]

results
aval-4=64 | reqp-181=2

report_methodology

command_line_options
-append=default::[not_specified] | -checks=default::[not_specified] | -fail_on=default::[not_specified] | -force=default::[not_specified]
-format=default::[not_specified] | -messages=default::[not_specified] | -name=default::[not_specified] | -return_string=default::[not_specified]
-slack_lesser_than=default::[not_specified] | -waived=default::[not_specified]

report_power

command_line_options
-advisory=default::[not_specified] | -append=default::[not_specified] | -file=[specified] | -format=default::text
-hier=default::power | -hierarchical_depth=default::4 | -l=default::[not_specified] | -name=default::[not_specified]
-no_propagation=default::[not_specified] | -return_string=default::[not_specified] | -rpx=[specified] | -verbose=default::[not_specified]
-vid=default::[not_specified] | -xpe=default::[not_specified]

usage
airflow=250 (LFM) | ambient_temp=25.0 (C) | bi-dir_toggle=12.500000 | bidir_output_enable=1.000000
board_layers=8to11 (8 to 11 Layers) | board_selection=medium (10"x10") | bram=0.035289 | clocks=0.037370
confidence_level_clock_activity=High | confidence_level_design_state=High | confidence_level_device_models=High | confidence_level_internal_activity=Medium
confidence_level_io_activity=High | confidence_level_overall=Medium | customer=TBD | customer_class=TBD
devstatic=0.148689 | die=xc7z020clg484-1 | dsp=0.122807 | dsp_output_toggle=12.500000
dynamic=1.791577 | effective_thetaja=11.5 | enable_probability=0.990000 | family=zynq
ff_toggle=12.500000 | flow_state=routed | heatsink=none | input_toggle=12.500000
junction_temp=47.4 (C) | logic=0.010465 | mgtavcc_dynamic_current=0.000000 | mgtavcc_static_current=0.000000
mgtavcc_total_current=0.000000 | mgtavcc_voltage=1.000000 | mgtavtt_dynamic_current=0.000000 | mgtavtt_static_current=0.000000
mgtavtt_total_current=0.000000 | mgtavtt_voltage=1.200000 | mgtvccaux_dynamic_current=0.000000 | mgtvccaux_static_current=0.000000
mgtvccaux_total_current=0.000000 | mgtvccaux_voltage=1.800000 | netlist_net_matched=NA | off-chip_power=0.000000
on-chip_power=1.940266 | output_enable=1.000000 | output_load=5.000000 | output_toggle=12.500000
package=clg484 | pct_clock_constrained=2.000000 | pct_inputs_defined=0 | platform=nt64
process=typical | ps7=1.532289 | ram_enable=50.000000 | ram_write=50.000000
read_saif=False | set/reset_probability=0.000000 | signal_rate=False | signals=0.053357
simulation_file=None | speedgrade=-1 | static_prob=False | temp_grade=commercial
thetajb=7.4 (C/W) | thetasa=0.0 (C/W) | toggle_rate=False | user_board_temp=25.0 (C)
user_effective_thetaja=11.5 | user_junc_temp=47.4 (C) | user_thetajb=7.4 (C/W) | user_thetasa=0.0 (C/W)
vccadc_dynamic_current=0.000000 | vccadc_static_current=0.020000 | vccadc_total_current=0.020000 | vccadc_voltage=1.800000
vccaux_dynamic_current=0.000000 | vccaux_io_dynamic_current=0.000000 | vccaux_io_static_current=0.000000 | vccaux_io_total_current=0.000000
vccaux_io_voltage=1.800000 | vccaux_static_current=0.016185 | vccaux_total_current=0.016185 | vccaux_voltage=1.800000
vccbram_dynamic_current=0.000935 | vccbram_static_current=0.001341 | vccbram_total_current=0.002276 | vccbram_voltage=1.000000
vccint_dynamic_current=0.258353 | vccint_static_current=0.016865 | vccint_total_current=0.275218 | vccint_voltage=1.000000
vcco12_dynamic_current=0.000000 | vcco12_static_current=0.000000 | vcco12_total_current=0.000000 | vcco12_voltage=1.200000
vcco135_dynamic_current=0.000000 | vcco135_static_current=0.000000 | vcco135_total_current=0.000000 | vcco135_voltage=1.350000
vcco15_dynamic_current=0.000000 | vcco15_static_current=0.000000 | vcco15_total_current=0.000000 | vcco15_voltage=1.500000
vcco18_dynamic_current=0.000000 | vcco18_static_current=0.000000 | vcco18_total_current=0.000000 | vcco18_voltage=1.800000
vcco25_dynamic_current=0.000000 | vcco25_static_current=0.000000 | vcco25_total_current=0.000000 | vcco25_voltage=2.500000
vcco33_dynamic_current=0.000000 | vcco33_static_current=0.000000 | vcco33_total_current=0.000000 | vcco33_voltage=3.300000
vcco_ddr_dynamic_current=0.456904 | vcco_ddr_static_current=0.002000 | vcco_ddr_total_current=0.458904 | vcco_ddr_voltage=1.500000
vcco_mio0_dynamic_current=0.001500 | vcco_mio0_static_current=0.001000 | vcco_mio0_total_current=0.002500 | vcco_mio0_voltage=3.300000
vcco_mio1_dynamic_current=0.002187 | vcco_mio1_static_current=0.001000 | vcco_mio1_total_current=0.003187 | vcco_mio1_voltage=1.800000
vccpaux_dynamic_current=0.051069 | vccpaux_static_current=0.010330 | vccpaux_total_current=0.061399 | vccpaux_voltage=1.800000
vccpint_dynamic_current=0.721142 | vccpint_static_current=0.033256 | vccpint_total_current=0.754399 | vccpint_voltage=1.000000
vccpll_dynamic_current=0.013878 | vccpll_static_current=0.003000 | vccpll_total_current=0.016878 | vccpll_voltage=1.800000

version=2019.1

report_utilization

clocking
bufgctrl_available=32 | bufgctrl_fixed=0 | bufgctrl_used=1 | bufgctrl_util_percentage=3.13
bufhce_available=72 | bufhce_fixed=0 | bufhce_used=0 | bufhce_util_percentage=0.00
bufio_available=16 | bufio_fixed=0 | bufio_used=0 | bufio_util_percentage=0.00
bufmrce_available=8 | bufmrce_fixed=0 | bufmrce_used=0 | bufmrce_util_percentage=0.00
bufr_available=16 | bufr_fixed=0 | bufr_used=0 | bufr_util_percentage=0.00
mmcme2_adv_available=4 | mmcme2_adv_fixed=0 | mmcme2_adv_used=0 | mmcme2_adv_util_percentage=0.00
plle2_adv_available=4 | plle2_adv_fixed=0 | plle2_adv_used=0 | plle2_adv_util_percentage=0.00

dsp
dsp48e1_only_used=64 | dsps_available=220 | dsps_fixed=0 | dsps_used=64

dsps_util_percentage=29.09

io_standard
blvds_25=0 | diff_hstl_i=0 | diff_hstl_i_18=0 | diff_hstl_ii=0
diff_hstl_ii_18=0 | diff_hsul_12=0 | diff_mobile_ddr=0 | diff_sstl135=0
diff_sstl135_r=0 | diff_sstl15=1 | diff_sstl15_r=0 | diff_sstl18_i=0
diff_sstl18_ii=0 | hstl_i=0 | hstl_i_18=0 | hstl_ii=0
hstl_ii_18=0 | hsul_12=0 | lvcmos12=0 | lvcmos15=0
lvcmos18=1 | lvcmos25=0 | lvcmos33=1 | lvds_25=0
lvttl=0 | mini_lvds_25=0 | mobile_ddr=0 | pci33_3=0
ppds_25=0 | rsds_25=0 | sstl135=0 | sstl135_r=0
sstl15=1 | sstl15_r=0 | sstl18_i=0 | sstl18_ii=0

tmds_33=0

memory
block_ram_tile_available=140 | block_ram_tile_fixed=0 | block_ram_tile_used=4.5 | block_ram_tile_util_percentage=3.21
ramb18_available=280 | ramb18_fixed=0 | ramb18_used=1 | ramb18_util_percentage=0.36
ramb18e1_only_used=1 | ramb36_fifo_available=140 | ramb36_fifo_fixed=0 | ramb36_fifo_used=4
ramb36_fifo_util_percentage=2.86 | ramb36e1_only_used=4

primitives
bibuf_functional_category=IO | bibuf_used=130 | bufg_functional_category=Clock | bufg_used=1
carry4_functional_category=CarryLogic | carry4_used=86 | dsp48e1_functional_category=Block Arithmetic | dsp48e1_used=64
fdre_functional_category=Flop & Latch | fdre_used=2944 | fdse_functional_category=Flop & Latch | fdse_used=53
lut1_functional_category=LUT | lut1_used=36 | lut2_functional_category=LUT | lut2_used=332
lut3_functional_category=LUT | lut3_used=315 | lut4_functional_category=LUT | lut4_used=127
lut5_functional_category=LUT | lut5_used=169 | lut6_functional_category=LUT | lut6_used=318
muxf7_functional_category=MuxFx | muxf7_used=22 | ps7_functional_category=Specialized Resource | ps7_used=1
ramb18e1_functional_category=Block Memory | ramb18e1_used=1 | ramb36e1_functional_category=Block Memory | ramb36e1_used=4
srl16e_functional_category=Distributed Memory | srl16e_used=19 | srlc32e_functional_category=Distributed Memory | srlc32e_used=45

slice_logic
f7_muxes_available=26600 | f7_muxes_fixed=0 | f7_muxes_used=22 | f7_muxes_util_percentage=0.08
f8_muxes_available=13300 | f8_muxes_fixed=0 | f8_muxes_used=0 | f8_muxes_util_percentage=0.00
lut_as_distributed_ram_fixed=0 | lut_as_distributed_ram_used=0 | lut_as_logic_available=53200 | lut_as_logic_fixed=0
lut_as_logic_used=1110 | lut_as_logic_util_percentage=2.09 | lut_as_memory_available=17400 | lut_as_memory_fixed=0
lut_as_memory_used=60 | lut_as_memory_util_percentage=0.34 | lut_as_shift_register_fixed=0 | lut_as_shift_register_used=60
register_as_flip_flop_available=106400 | register_as_flip_flop_fixed=0 | register_as_flip_flop_used=2997 | register_as_flip_flop_util_percentage=2.82
register_as_latch_available=106400 | register_as_latch_fixed=0 | register_as_latch_used=0 | register_as_latch_util_percentage=0.00
slice_luts_available=53200 | slice_luts_fixed=0 | slice_luts_used=1170 | slice_luts_util_percentage=2.20
slice_registers_available=106400 | slice_registers_fixed=0 | slice_registers_used=2997 | slice_registers_util_percentage=2.82
lut_as_distributed_ram_fixed=0 | lut_as_distributed_ram_used=0 | lut_as_logic_available=53200 | lut_as_logic_fixed=0
lut_as_logic_used=1110 | lut_as_logic_util_percentage=2.09 | lut_as_memory_available=17400 | lut_as_memory_fixed=0
lut_as_memory_used=60 | lut_as_memory_util_percentage=0.34 | lut_as_shift_register_fixed=0 | lut_as_shift_register_used=60
lut_in_front_of_the_register_is_unused_fixed=60 | lut_in_front_of_the_register_is_unused_used=1866 | lut_in_front_of_the_register_is_used_fixed=1866 | lut_in_front_of_the_register_is_used_used=296
register_driven_from_outside_the_slice_fixed=296 | register_driven_from_outside_the_slice_used=2162 | register_driven_from_within_the_slice_fixed=2162 | register_driven_from_within_the_slice_used=835
slice_available=13300 | slice_fixed=0 | slice_registers_available=106400 | slice_registers_fixed=0
slice_registers_used=2997 | slice_registers_util_percentage=2.82 | slice_used=805 | slice_util_percentage=6.05
slicel_fixed=0 | slicel_used=509 | slicem_fixed=0 | slicem_used=296
unique_control_sets_available=13300 | unique_control_sets_fixed=13300 | unique_control_sets_used=82 | unique_control_sets_util_percentage=0.62
using_o5_and_o6_fixed=0.62 | using_o5_and_o6_used=4 | using_o5_output_only_fixed=4 | using_o5_output_only_used=0
using_o6_output_only_fixed=0 | using_o6_output_only_used=56

specific_feature
bscane2_available=4 | bscane2_fixed=0 | bscane2_used=0 | bscane2_util_percentage=0.00
capturee2_available=1 | capturee2_fixed=0 | capturee2_used=0 | capturee2_util_percentage=0.00
dna_port_available=1 | dna_port_fixed=0 | dna_port_used=0 | dna_port_util_percentage=0.00
efuse_usr_available=1 | efuse_usr_fixed=0 | efuse_usr_used=0 | efuse_usr_util_percentage=0.00
frame_ecce2_available=1 | frame_ecce2_fixed=0 | frame_ecce2_used=0 | frame_ecce2_util_percentage=0.00
icape2_available=2 | icape2_fixed=0 | icape2_used=0 | icape2_util_percentage=0.00
startupe2_available=1 | startupe2_fixed=0 | startupe2_used=0 | startupe2_util_percentage=0.00
xadc_available=1 | xadc_fixed=0 | xadc_used=0 | xadc_util_percentage=0.00

synthesis

command_line_options
-assert=default::[not_specified] | -bufg=default::12 | -cascade_dsp=default::auto | -constrset=default::[not_specified]
-control_set_opt_threshold=default::auto | -directive=default::default | -fanout_limit=default::10000 | -flatten_hierarchy=default::rebuilt
-fsm_extraction=default::auto | -gated_clock_conversion=default::off | -generic=default::[not_specified] | -include_dirs=default::[not_specified]
-keep_equivalent_registers=default::[not_specified] | -max_bram=default::-1 | -max_bram_cascade_height=default::-1 | -max_dsp=default::-1
-max_uram=default::-1 | -max_uram_cascade_height=default::-1 | -mode=default::default | -name=default::[not_specified]
-no_lc=default::[not_specified] | -no_srlextract=default::[not_specified] | -no_timing_driven=default::[not_specified] | -part=xc7z020clg484-1
-resource_sharing=default::auto | -retiming=default::[not_specified] | -rtl=default::[not_specified] | -rtl_skip_constraints=default::[not_specified]
-rtl_skip_ip=default::[not_specified] | -seu_protect=default::none | -sfcu=default::[not_specified] | -shreg_min_size=default::3
-top=system_wrapper | -verilog_define=default::[not_specified]

usage
elapsed=00:00:28s | hls_ip=0 | memory_gain=664.398MB | memory_peak=1052.266MB

xsim

command_line_options
-sim_mode=default::behavioral | -sim_type=default::
