Titaniumthunder/MAC-Attack/model/results/E3_single_accel/analysis.md

# E3_single_accel: three single-accelerometer variants (generated by single_accel.py)

Validation numbers decide; test numbers are reported for every variant but were not used to choose.

## Validation (recordings, mean ± std over seeds 42, 43, 44)

| Variant | Recall | Balanced acc. | F1 | Precision | Specificity | ROC-AUC | Worst-seed recall | Window ROC-AUC | Best val loss | Rank |
|---|---|---|---|---|---|---|---|---|---|---|
| a1 | 1.000 ± 0.000 | 1.000 ± 0.000 | 1.000 ± 0.000 | 1.000 ± 0.000 | 1.000 ± 0.000 | 1.000 ± 0.000 | 1.000 | 0.9990 ± 0.0002 | 0.0102 ± 0.0009 | 3 |
| a2 | 1.000 ± 0.000 | 1.000 ± 0.000 | 1.000 ± 0.000 | 1.000 ± 0.000 | 1.000 ± 0.000 | 1.000 ± 0.000 | 1.000 | 1.0000 ± 0.0000 | 0.0022 ± 0.0002 | 1 |
| a3 | 1.000 ± 0.000 | 1.000 ± 0.000 | 1.000 ± 0.000 | 1.000 ± 0.000 | 1.000 ± 0.000 | 1.000 ± 0.000 | 1.000 | 0.9998 ± 0.0003 | 0.0037 ± 0.0013 | 2 |

**Selected: accelerometer 2 (E3_single_accel_a2)**, seed 42 exported.

## Every seed, train

| Variant | Seed | Acc. | Prec. | Recall | F1 | Bal. acc. | Spec. | ROC-AUC | MCC | [[TN,FP],[FN,TP]] | Faults found | Window ROC-AUC |
|---|---|---|---|---|---|---|---|---|---|---|---|---|
| a1 | 42 | 1.000 | 1.000 | 1.000 | 1.000 | 1.000 | 1.000 | 1.000 | 1.000 | [[8, 0], [0, 56]] | 56/56 | 1.0000 |
| a1 | 43 | 1.000 | 1.000 | 1.000 | 1.000 | 1.000 | 1.000 | 1.000 | 1.000 | [[8, 0], [0, 56]] | 56/56 | 1.0000 |
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

| Variant | 2 (30->30 Hz) | 7 (45->15 Hz) |
|---|---|---|
| a1 | 0/14 0/14 0/14 | 0/14 0/14 0/14 |
| a2 | 0/14 0/14 0/14 | 0/14 0/14 0/14 |
| a3 | 0/14 0/14 0/14 | 0/14 0/14 0/14 |

## Missed faults by class (val; seeds 42, 43, 44, of n)

| Variant | B_R | F_B | K_A | R_M | R_U | S_W | V_U |
|---|---|---|---|---|---|---|---|
| a1 | 0 0 0 of 4 | 0 0 0 of 4 | 0 0 0 of 4 | 0 0 0 of 4 | 0 0 0 of 4 | 0 0 0 of 4 | 0 0 0 of 4 |
| a2 | 0 0 0 of 4 | 0 0 0 of 4 | 0 0 0 of 4 | 0 0 0 of 4 | 0 0 0 of 4 | 0 0 0 of 4 | 0 0 0 of 4 |
| a3 | 0 0 0 of 4 | 0 0 0 of 4 | 0 0 0 of 4 | 0 0 0 of 4 | 0 0 0 of 4 | 0 0 0 of 4 | 0 0 0 of 4 |

## Recordings by speed code (test): missed faults / false alarms per seed 42, 43, 44

| Variant | 1 (15->15 Hz) | 6 (30->60 Hz) |
|---|---|---|
| a1 | 0/14 0/14 0/14 | 0/14 0/14 0/14 |
| a2 | 2/14 2/14 2/14 | 0/14 0/14 0/14 |
| a3 | 1/14 0/14 0/14 | 0/14 1/14 2/14 |

## Missed faults by class (test; seeds 42, 43, 44, of n)

| Variant | B_R | F_B | K_A | R_M | R_U | S_W | V_U |
|---|---|---|---|---|---|---|---|
| a1 | 0 0 0 of 4 | 0 0 0 of 4 | 0 0 0 of 4 | 0 0 0 of 4 | 0 0 0 of 4 | 0 0 0 of 4 | 0 0 0 of 4 |
| a2 | 0 0 0 of 4 | 1 1 1 of 4 | 0 0 0 of 4 | 0 0 0 of 4 | 0 0 0 of 4 | 1 1 1 of 4 | 0 0 0 of 4 |
| a3 | 0 0 0 of 4 | 0 1 1 of 4 | 0 0 0 of 4 | 0 0 0 of 4 | 1 0 0 of 4 | 0 0 1 of 4 | 0 0 0 of 4 |

## Windows by drive frequency (val + test; errors at the recording cut; seeds 42, 43, 44)

| Variant | 14-20 Hz | 20-30 Hz | 30-40 Hz | 40-50 Hz | 50-61 Hz |
|---|---|---|---|---|---|
| a1 | missed 0/0/0 of 168; FA 1/1/1 of 24 | missed 0/0/0 of 42; FA 0/0/0 of 6 | missed 7/7/7 of 221; FA 0/0/0 of 31 | missed 0/0/0 of 81; FA 0/0/0 of 11 | missed 0/0/0 of 48; FA 0/0/0 of 8 |
| a2 | missed 26/21/21 of 168; FA 0/0/0 of 24 | missed 1/1/1 of 42; FA 0/0/0 of 6 | missed 25/21/24 of 221; FA 0/0/0 of 31 | missed 0/0/0 of 81; FA 0/0/0 of 11 | missed 1/0/0 of 48; FA 0/0/0 of 8 |
| a3 | missed 18/14/14 of 168; FA 0/0/0 of 24 | missed 0/0/0 of 42; FA 0/0/0 of 6 | missed 30/34/34 of 221; FA 0/0/0 of 31 | missed 14/21/20 of 81; FA 0/0/0 of 11 | missed 9/6/7 of 48; FA 0/0/0 of 8 |

## Health index (H1 method) on each single accelerometer

| Accel | D_100 | D_0 | ROC-AUC of D train / val / test | Healthy HI val | Healthy HI test | Faulty HI median val / test | Faulty at 100% val / test |
|---|---|---|---|---|---|---|---|
| a1 | 1.920 | 4.491 | 1.000 / 1.000 / 0.929 | H_H_2_0 100, H_H_7_0 100, H_H_2_1 100, H_H_7_1 100 | H_H_1_0 94, H_H_6_0 100, H_H_1_1 100, H_H_6_1 100 | 37 / 46 | 1/28 / 4/28 |
| a2 | 3.208 | 4.114 | 1.000 / 1.000 / 1.000 | H_H_2_0 100, H_H_7_0 100, H_H_2_1 100, H_H_7_1 100 | H_H_1_0 100, H_H_6_0 100, H_H_1_1 100, H_H_6_1 100 | 45 / 59 | 10/28 / 11/28 |
| a3 | 2.561 | 2.007 | 0.953 / 0.705 / 0.500 | H_H_2_0 0, H_H_7_0 97, H_H_2_1 0, H_H_7_1 100 | H_H_1_0 100, H_H_6_0 0, H_H_1_1 100, H_H_6_1 0 | 100 / 71 | 19/28 / 12/28 |

## Health index per speed code (HI %: healthy recordings; faulty min / median / max)

| Speed code | a1 healthy | a1 faulty | a2 healthy | a2 faulty | a3 healthy | a3 faulty |
|---|---|---|---|---|---|---|
| 1 (15->15 Hz) | 94, 100 | 64 / 82 / 100 | 100, 100 | 0 / 100 / 100 | 100, 100 | 29 / 100 / 100 |
| 2 (30->30 Hz) | 100, 100 | 0 / 33 / 100 | 100, 100 | 0 / 46 / 100 | 0, 0 | 0 / 100 / 100 |
| 3 (45->45 Hz) | 100, 100 | 0 / 5 / 55 | 100, 100 | 0 / 0 / 100 | 0, 0 | 0 / 0 / 2 |
| 4 (60->60 Hz) | 100, 100 | 0 / 0 / 62 | 100, 100 | 0 / 83 / 100 | 0, 0 | 0 / 0 / 100 |
| 5 (15->45 Hz) | 100, 100 | 0 / 32 / 56 | 100, 100 | 0 / 19 / 100 | 0, 0 | 0 / 100 / 100 |
| 6 (30->60 Hz) | 100, 100 | 0 / 0 / 29 | 100, 100 | 0 / 0 / 86 | 0, 0 | 0 / 0 / 82 |
| 7 (45->15 Hz) | 100, 100 | 0 / 37 / 73 | 100, 100 | 0 / 45 / 100 | 97, 100 | 0 / 100 / 100 |
| 8 (60->30 Hz) | 100, 100 | 0 / 0 / 60 | 100, 100 | 0 / 0 / 100 | 0, 0 | 0 / 27 / 100 |

## Low-speed healthy recordings: mean z per statistic (distance from the healthy reference line)

a1:

| Recording | log_std | log_rms | log_absmax | log_p2p | crest | skew | kurt |
|---|---|---|---|---|---|---|---|
| H_H_1_0 | -1.42 | +3.04 | +0.26 | -1.82 | -3.83 | -0.65 | -0.40 |
| H_H_1_1 | -1.39 | +2.75 | +0.36 | -1.55 | -3.42 | +0.07 | -0.34 |
| H_H_7_0 | +0.15 | +0.18 | +0.27 | +0.07 | +0.17 | +0.62 | -0.15 |
| H_H_7_1 | +0.25 | +0.92 | +0.73 | +0.41 | -0.31 | +0.33 | +0.17 |

a2:

| Recording | log_std | log_rms | log_absmax | log_p2p | crest | skew | kurt |
|---|---|---|---|---|---|---|---|
| H_H_1_0 | -1.85 | +0.12 | -0.95 | -1.03 | -1.13 | -0.67 | -0.62 |
| H_H_1_1 | -1.14 | -0.20 | -1.31 | -1.39 | -1.37 | -0.69 | -0.72 |
| H_H_7_0 | +0.01 | +0.34 | +1.12 | +1.03 | +1.26 | -0.16 | +0.59 |
| H_H_7_1 | -1.18 | -0.68 | -1.20 | -1.16 | -0.99 | +0.50 | -0.41 |

a3:

| Recording | log_std | log_rms | log_absmax | log_p2p | crest | skew | kurt |
|---|---|---|---|---|---|---|---|
| H_H_1_0 | +0.77 | +1.78 | +2.81 | +2.74 | +3.57 | -15.34 | +32.26 |
| H_H_1_1 | +0.93 | +2.04 | +2.27 | +2.26 | +1.65 | -5.59 | +15.98 |
| H_H_7_0 | -0.17 | -0.10 | +0.26 | +0.24 | +0.73 | -2.18 | +4.27 |
| H_H_7_1 | -0.16 | -0.02 | +0.39 | +0.41 | +0.97 | -3.15 | +7.33 |
