Titaniumthunder/MAC-Attack/Marco/openlane_results/metrics.csv

Metric | Value
design__lint_error__count | 0
design__lint_timing_construct__count | 0
design__lint_warning__count | 55
design__inferred_latch__count | 0
design__instance__count | 39167
design__instance__area | 330800
design__instance_unmapped__count | 0
synthesis__check_error__count | 0
design__max_slew_violation__count__corner:nom_tt_025C_1v80 | 0
design__max_fanout_violation__count__corner:nom_tt_025C_1v80 | 299
design__max_cap_violation__count__corner:nom_tt_025C_1v80 | 4
power__internal__total | 0.012630471028387547
power__switching__total | 0.00427494291216135
power__leakage__total | 3.909808583557606E-7
power__total | 0.016905805096030235
clock__skew__worst_hold__corner:nom_tt_025C_1v80 | -0.5075149333327709
clock__skew__worst_setup__corner:nom_tt_025C_1v80 | 0.48753680250652837
timing__hold__ws__corner:nom_tt_025C_1v80 | 0.2973210650725048
timing__setup__ws__corner:nom_tt_025C_1v80 | 13.603077271857765
timing__hold__tns__corner:nom_tt_025C_1v80 | 0.0
timing__setup__tns__corner:nom_tt_025C_1v80 | 0.0
timing__hold__wns__corner:nom_tt_025C_1v80 | 0
timing__setup__wns__corner:nom_tt_025C_1v80 | 0.0
timing__hold_vio__count__corner:nom_tt_025C_1v80 | 0
timing__hold_r2r__ws__corner:nom_tt_025C_1v80 | 0.297321
timing__hold_r2r_vio__count__corner:nom_tt_025C_1v80 | 0
timing__setup_vio__count__corner:nom_tt_025C_1v80 | 0
timing__setup_r2r__ws__corner:nom_tt_025C_1v80 | 13.603077
timing__setup_r2r_vio__count__corner:nom_tt_025C_1v80 | 0
design__max_slew_violation__count__corner:nom_ss_100C_1v60 | 128
design__max_fanout_violation__count__corner:nom_ss_100C_1v60 | 299
design__max_cap_violation__count__corner:nom_ss_100C_1v60 | 4
clock__skew__worst_hold__corner:nom_ss_100C_1v60 | -0.7122547198080114
clock__skew__worst_setup__corner:nom_ss_100C_1v60 | 0.6673821684188392
timing__hold__ws__corner:nom_ss_100C_1v60 | 0.8090950360927964
timing__setup__ws__corner:nom_ss_100C_1v60 | 0.6563194617993896
timing__hold__tns__corner:nom_ss_100C_1v60 | 0.0
timing__setup__tns__corner:nom_ss_100C_1v60 | 0.0
timing__hold__wns__corner:nom_ss_100C_1v60 | 0
timing__setup__wns__corner:nom_ss_100C_1v60 | 0.0
timing__hold_vio__count__corner:nom_ss_100C_1v60 | 0
timing__hold_r2r__ws__corner:nom_ss_100C_1v60 | 0.809095
timing__hold_r2r_vio__count__corner:nom_ss_100C_1v60 | 0
timing__setup_vio__count__corner:nom_ss_100C_1v60 | 0
timing__setup_r2r__ws__corner:nom_ss_100C_1v60 | 0.656319
timing__setup_r2r_vio__count__corner:nom_ss_100C_1v60 | 0
design__max_slew_violation__count__corner:nom_ff_n40C_1v95 | 0
design__max_fanout_violation__count__corner:nom_ff_n40C_1v95 | 299
design__max_cap_violation__count__corner:nom_ff_n40C_1v95 | 4
clock__skew__worst_hold__corner:nom_ff_n40C_1v95 | -0.42664425977487563
clock__skew__worst_setup__corner:nom_ff_n40C_1v95 | 0.4145406080180975
timing__hold__ws__corner:nom_ff_n40C_1v95 | 0.0903275257935347
timing__setup__ws__corner:nom_ff_n40C_1v95 | 17.860465612006575
timing__hold__tns__corner:nom_ff_n40C_1v95 | 0.0
timing__setup__tns__corner:nom_ff_n40C_1v95 | 0.0
timing__hold__wns__corner:nom_ff_n40C_1v95 | 0
timing__setup__wns__corner:nom_ff_n40C_1v95 | 0.0
timing__hold_vio__count__corner:nom_ff_n40C_1v95 | 0
timing__hold_r2r__ws__corner:nom_ff_n40C_1v95 | 0.090328
timing__hold_r2r_vio__count__corner:nom_ff_n40C_1v95 | 0
timing__setup_vio__count__corner:nom_ff_n40C_1v95 | 0
timing__setup_r2r__ws__corner:nom_ff_n40C_1v95 | 18.221115
timing__setup_r2r_vio__count__corner:nom_ff_n40C_1v95 | 0
design__max_slew_violation__count | 176
design__max_fanout_violation__count | 299
design__max_cap_violation__count | 5
clock__skew__worst_hold | -0.4202751876582276
clock__skew__worst_setup | 0.4084815101786915
timing__hold__ws | 0.07930489822640757
timing__setup__ws | 0.24758862327789138
timing__hold__tns | 0.0
timing__setup__tns | 0.0
timing__hold__wns | 0
timing__setup__wns | 0.0
timing__hold_vio__count | 0
timing__hold_r2r__ws | 0.079305
timing__hold_r2r_vio__count | 0
timing__setup_vio__count | 0
timing__setup_r2r__ws | 0.247589
timing__setup_r2r_vio__count | 0
design__die__bbox | 0.0 0.0 771.99 782.71
design__core__bbox | 5.52 10.88 766.36 769.76
design__io | 7
design__die__area | 604244
design__core__area | 577386
design__instance__count__stdcell | 39167
design__instance__area__stdcell | 330800
design__instance__count__macros | 0
design__instance__area__macros | 0
design__instance__utilization | 0.572926
design__instance__utilization__stdcell | 0.572926
design__instance__count__class:inverter | 313
design__instance__count__class:sequential_cell | 4997
design__instance__count__class:multi_input_combinational_cell | 18716
flow__warnings__count | 1
flow__errors__count | 0
design__instance__count__class:fill_cell | 35049
design__instance__count__class:tap_cell | 8149
design__power_grid_violation__count__net:VGND | 0
design__power_grid_violation__count__net:VPWR | 0
design__power_grid_violation__count | 0
floorplan__design__io | 5
design__io__hpwl | 3421884
timing__drv__floating__nets | 0
timing__drv__floating__pins | 0
design__instance__displacement__total | 0
design__instance__displacement__mean | 0
design__instance__displacement__max | 0
route__wirelength__estimated | 714642
design__violations | 0
design__instance__count__class:timing_repair_buffer | 5891
design__instance__count__class:clock_buffer | 593
design__instance__count__class:clock_inverter | 374
design__instance__count__setup_buffer | 0
design__instance__count__hold_buffer | 3806
antenna__violating__nets | 20
antenna__violating__pins | 21
route__antenna_violation__count | 20
antenna_diodes_count | 134
design__instance__count__class:antenna_cell | 134
route__net | 30446
route__net__special | 2
route__drc_errors__iter:1 | 11893
route__wirelength__iter:1 | 841586
route__drc_errors__iter:2 | 4912
route__wirelength__iter:2 | 834756
route__drc_errors__iter:3 | 4230
route__wirelength__iter:3 | 833422
route__drc_errors__iter:4 | 277
route__wirelength__iter:4 | 832158
route__drc_errors__iter:5 | 6
route__wirelength__iter:5 | 832138
route__drc_errors__iter:6 | 0
route__wirelength__iter:6 | 832133
route__drc_errors | 0
route__wirelength | 832133
route__vias | 209551
route__vias__singlecut | 209551
route__vias__multicut | 0
design__disconnected_pin__count | 0
design__critical_disconnected_pin__count | 0
route__wirelength__max | 985.34
timing__unannotated_net__count__corner:nom_tt_025C_1v80 | 441
timing__unannotated_net_filtered__count__corner:nom_tt_025C_1v80 | 0
timing__unannotated_net__count__corner:nom_ss_100C_1v60 | 441
timing__unannotated_net_filtered__count__corner:nom_ss_100C_1v60 | 0
timing__unannotated_net__count__corner:nom_ff_n40C_1v95 | 441
timing__unannotated_net_filtered__count__corner:nom_ff_n40C_1v95 | 0
design__max_slew_violation__count__corner:min_tt_025C_1v80 | 0
design__max_fanout_violation__count__corner:min_tt_025C_1v80 | 299
design__max_cap_violation__count__corner:min_tt_025C_1v80 | 4
clock__skew__worst_hold__corner:min_tt_025C_1v80 | -0.4976005304201672
clock__skew__worst_setup__corner:min_tt_025C_1v80 | 0.47905825107228117
timing__hold__ws__corner:min_tt_025C_1v80 | 0.2964222284863474
timing__setup__ws__corner:min_tt_025C_1v80 | 13.824644043059335
timing__hold__tns__corner:min_tt_025C_1v80 | 0.0
timing__setup__tns__corner:min_tt_025C_1v80 | 0.0
timing__hold__wns__corner:min_tt_025C_1v80 | 0
timing__setup__wns__corner:min_tt_025C_1v80 | 0.0
timing__hold_vio__count__corner:min_tt_025C_1v80 | 0
timing__hold_r2r__ws__corner:min_tt_025C_1v80 | 0.296422
timing__hold_r2r_vio__count__corner:min_tt_025C_1v80 | 0
timing__setup_vio__count__corner:min_tt_025C_1v80 | 0
timing__setup_r2r__ws__corner:min_tt_025C_1v80 | 13.824644
timing__setup_r2r_vio__count__corner:min_tt_025C_1v80 | 0
timing__unannotated_net__count__corner:min_tt_025C_1v80 | 441
timing__unannotated_net_filtered__count__corner:min_tt_025C_1v80 | 0
design__max_slew_violation__count__corner:min_ss_100C_1v60 | 67
design__max_fanout_violation__count__corner:min_ss_100C_1v60 | 299
design__max_cap_violation__count__corner:min_ss_100C_1v60 | 4
clock__skew__worst_hold__corner:min_ss_100C_1v60 | -0.6953398054156459
clock__skew__worst_setup__corner:min_ss_100C_1v60 | 0.655009620637892
timing__hold__ws__corner:min_ss_100C_1v60 | 0.8060612405699041
timing__setup__ws__corner:min_ss_100C_1v60 | 1.0722729674341602
timing__hold__tns__corner:min_ss_100C_1v60 | 0.0
timing__setup__tns__corner:min_ss_100C_1v60 | 0.0
timing__hold__wns__corner:min_ss_100C_1v60 | 0
timing__setup__wns__corner:min_ss_100C_1v60 | 0.0
timing__hold_vio__count__corner:min_ss_100C_1v60 | 0
timing__hold_r2r__ws__corner:min_ss_100C_1v60 | 0.806061
timing__hold_r2r_vio__count__corner:min_ss_100C_1v60 | 0
timing__setup_vio__count__corner:min_ss_100C_1v60 | 0
timing__setup_r2r__ws__corner:min_ss_100C_1v60 | 1.072273
timing__setup_r2r_vio__count__corner:min_ss_100C_1v60 | 0
timing__unannotated_net__count__corner:min_ss_100C_1v60 | 441
timing__unannotated_net_filtered__count__corner:min_ss_100C_1v60 | 0
design__max_slew_violation__count__corner:min_ff_n40C_1v95 | 0
design__max_fanout_violation__count__corner:min_ff_n40C_1v95 | 299
design__max_cap_violation__count__corner:min_ff_n40C_1v95 | 4
clock__skew__worst_hold__corner:min_ff_n40C_1v95 | -0.4202751876582276
clock__skew__worst_setup__corner:min_ff_n40C_1v95 | 0.4084815101786915
timing__hold__ws__corner:min_ff_n40C_1v95 | 0.09436807158362993
timing__setup__ws__corner:min_ff_n40C_1v95 | 17.91673171648589
timing__hold__tns__corner:min_ff_n40C_1v95 | 0.0
timing__setup__tns__corner:min_ff_n40C_1v95 | 0.0
timing__hold__wns__corner:min_ff_n40C_1v95 | 0
timing__setup__wns__corner:min_ff_n40C_1v95 | 0.0
timing__hold_vio__count__corner:min_ff_n40C_1v95 | 0
timing__hold_r2r__ws__corner:min_ff_n40C_1v95 | 0.094368
timing__hold_r2r_vio__count__corner:min_ff_n40C_1v95 | 0
timing__setup_vio__count__corner:min_ff_n40C_1v95 | 0
timing__setup_r2r__ws__corner:min_ff_n40C_1v95 | 18.363710
timing__setup_r2r_vio__count__corner:min_ff_n40C_1v95 | 0
timing__unannotated_net__count__corner:min_ff_n40C_1v95 | 441
timing__unannotated_net_filtered__count__corner:min_ff_n40C_1v95 | 0
design__max_slew_violation__count__corner:max_tt_025C_1v80 | 0
design__max_fanout_violation__count__corner:max_tt_025C_1v80 | 299
design__max_cap_violation__count__corner:max_tt_025C_1v80 | 5
clock__skew__worst_hold__corner:max_tt_025C_1v80 | -0.5152705075129349
clock__skew__worst_setup__corner:max_tt_025C_1v80 | 0.49326599756483674
timing__hold__ws__corner:max_tt_025C_1v80 | 0.2847959726436598
timing__setup__ws__corner:max_tt_025C_1v80 | 13.397311195189536
timing__hold__tns__corner:max_tt_025C_1v80 | 0.0
timing__setup__tns__corner:max_tt_025C_1v80 | 0.0
timing__hold__wns__corner:max_tt_025C_1v80 | 0
timing__setup__wns__corner:max_tt_025C_1v80 | 0.0
timing__hold_vio__count__corner:max_tt_025C_1v80 | 0
timing__hold_r2r__ws__corner:max_tt_025C_1v80 | 0.284796
timing__hold_r2r_vio__count__corner:max_tt_025C_1v80 | 0
timing__setup_vio__count__corner:max_tt_025C_1v80 | 0
timing__setup_r2r__ws__corner:max_tt_025C_1v80 | 13.397311
timing__setup_r2r_vio__count__corner:max_tt_025C_1v80 | 0
timing__unannotated_net__count__corner:max_tt_025C_1v80 | 441
timing__unannotated_net_filtered__count__corner:max_tt_025C_1v80 | 0
design__max_slew_violation__count__corner:max_ss_100C_1v60 | 176
design__max_fanout_violation__count__corner:max_ss_100C_1v60 | 299
design__max_cap_violation__count__corner:max_ss_100C_1v60 | 5
clock__skew__worst_hold__corner:max_ss_100C_1v60 | -0.7218925661573592
clock__skew__worst_setup__corner:max_ss_100C_1v60 | 0.6749883065756624
timing__hold__ws__corner:max_ss_100C_1v60 | 0.8150138572490737
timing__setup__ws__corner:max_ss_100C_1v60 | 0.24758862327789138
timing__hold__tns__corner:max_ss_100C_1v60 | 0.0
timing__setup__tns__corner:max_ss_100C_1v60 | 0.0
timing__hold__wns__corner:max_ss_100C_1v60 | 0
timing__setup__wns__corner:max_ss_100C_1v60 | 0.0
timing__hold_vio__count__corner:max_ss_100C_1v60 | 0
timing__hold_r2r__ws__corner:max_ss_100C_1v60 | 0.815014
timing__hold_r2r_vio__count__corner:max_ss_100C_1v60 | 0
timing__setup_vio__count__corner:max_ss_100C_1v60 | 0
timing__setup_r2r__ws__corner:max_ss_100C_1v60 | 0.247589
timing__setup_r2r_vio__count__corner:max_ss_100C_1v60 | 0
timing__unannotated_net__count__corner:max_ss_100C_1v60 | 441
timing__unannotated_net_filtered__count__corner:max_ss_100C_1v60 | 0
design__max_slew_violation__count__corner:max_ff_n40C_1v95 | 0
design__max_fanout_violation__count__corner:max_ff_n40C_1v95 | 299
design__max_cap_violation__count__corner:max_ff_n40C_1v95 | 5
clock__skew__worst_hold__corner:max_ff_n40C_1v95 | -0.4319835444959082
clock__skew__worst_setup__corner:max_ff_n40C_1v95 | 0.41880020081714636
timing__hold__ws__corner:max_ff_n40C_1v95 | 0.07930489822640757
timing__setup__ws__corner:max_ff_n40C_1v95 | 17.806322254010375
timing__hold__tns__corner:max_ff_n40C_1v95 | 0.0
timing__setup__tns__corner:max_ff_n40C_1v95 | 0.0
timing__hold__wns__corner:max_ff_n40C_1v95 | 0
timing__setup__wns__corner:max_ff_n40C_1v95 | 0.0
timing__hold_vio__count__corner:max_ff_n40C_1v95 | 0
timing__hold_r2r__ws__corner:max_ff_n40C_1v95 | 0.079305
timing__hold_r2r_vio__count__corner:max_ff_n40C_1v95 | 0
timing__setup_vio__count__corner:max_ff_n40C_1v95 | 0
timing__setup_r2r__ws__corner:max_ff_n40C_1v95 | 18.087381
timing__setup_r2r_vio__count__corner:max_ff_n40C_1v95 | 0
timing__unannotated_net__count__corner:max_ff_n40C_1v95 | 441
timing__unannotated_net_filtered__count__corner:max_ff_n40C_1v95 | 0
timing__unannotated_net__count | 441
timing__unannotated_net_filtered__count | 0
design_powergrid__voltage__worst__net:VPWR__corner:nom_tt_025C_1v80 | 1.79928
design_powergrid__drop__average__net:VPWR__corner:nom_tt_025C_1v80 | 1.79993
design_powergrid__drop__worst__net:VPWR__corner:nom_tt_025C_1v80 | 0.000724826
design_powergrid__voltage__worst__net:VGND__corner:nom_tt_025C_1v80 | 0.000578972
design_powergrid__drop__average__net:VGND__corner:nom_tt_025C_1v80 | 0.0000716633
design_powergrid__drop__worst__net:VGND__corner:nom_tt_025C_1v80 | 0.000578972
design_powergrid__voltage__worst | 0.000578972
design_powergrid__voltage__worst__net:VPWR | 1.79928
design_powergrid__drop__worst | 0.000724826
design_powergrid__drop__worst__net:VPWR | 0.000724826
design_powergrid__voltage__worst__net:VGND | 0.000578972
design_powergrid__drop__worst__net:VGND | 0.000578972
ir__voltage__worst | 1.8000000000000000444089209850062616169452667236328125
ir__drop__avg | 0.00007250000000000000042500725161431773813092149794101715087890625
ir__drop__worst | 0.0007249999999999999500399638918679556809365749359130859375
design__xor_difference__count | 0
magic__drc_error__count | 0
klayout__drc_error__count | 0
magic__illegal_overlap__count | 0
design__lvs_device_difference__count | 0
design__lvs_net_difference__count | 0
design__lvs_property_fail__count | 0
design__lvs_error__count | 0
design__lvs_unmatched_device__count | 0
design__lvs_unmatched_net__count | 0
design__lvs_unmatched_pin__count | 0
