Titaniumthunder/MAC-Attack/model/export/E3_single_accel_a1/vectors/test_recordings.csv

file | cls | label | speed | load | sum_logit_int | ten_T_int | faulty_int8 | score_fp32 | faulty_fp32
B_R_1_0.csv | B_R | 1 | 1 | 0 | 118680 | -13080 | 1 | 5.712860822677612 | 1
B_R_6_0.csv | B_R | 1 | 6 | 0 | 197149 | -13080 | 1 | 9.29724316596985 | 1
F_B_1_0.csv | F_B | 1 | 1 | 0 | 97827 | -13080 | 1 | 4.603602766990662 | 1
F_B_6_0.csv | F_B | 1 | 6 | 0 | 262541 | -13080 | 1 | 12.392614698410034 | 1
H_H_1_0.csv | H_H | 0 | 1 | 0 | -72303 | -13080 | 0 | -3.3937076568603515 | 0
H_H_6_0.csv | H_H | 0 | 6 | 0 | -261738 | -13080 | 0 | -12.385564041137695 | 0
K_A_1_0.csv | K_A | 1 | 1 | 0 | 136670 | -13080 | 1 | 6.542344760894776 | 1
K_A_6_0.csv | K_A | 1 | 6 | 0 | 232191 | -13080 | 1 | 11.019723796844483 | 1
R_M_1_0.csv | R_M | 1 | 1 | 0 | 252680 | -13080 | 1 | 11.96870460510254 | 1
R_M_6_0.csv | R_M | 1 | 6 | 0 | 270598 | -13080 | 1 | 12.770186185836792 | 1
R_U_1_0.csv | R_U | 1 | 1 | 0 | 115462 | -13080 | 1 | 5.407471418380737 | 1
R_U_6_0.csv | R_U | 1 | 6 | 0 | 232698 | -13080 | 1 | 11.070211124420165 | 1
S_W_1_0.csv | S_W | 1 | 1 | 0 | 37180 | -13080 | 1 | 1.7733748793601989 | 1
S_W_6_0.csv | S_W | 1 | 6 | 0 | 211597 | -13080 | 1 | 10.061620998382569 | 1
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
