Titaniumthunder/MAC-Attack/model/export/E3_single_accel_a1/vectors/test_windows.csv

file | window | label | f_hz | x0 | x1 | x2 | x3 | x4 | x5 | x6 | x7 | q0 | q1 | q2 | q3 | q4 | q5 | q6 | q7 | C | logit_int | logit_fp32
B_R_1_0.csv | 0 | 1 | 15.0 | 1.1031255903723058 | 1.5277983264469033 | 2.8217980247489423 | 3.3024169106901375 | 3.6473457026598424 | 0.4415891384384792 | 3.963131535914407 | 2.70805020110221 | -62 | -55 | -51 | -50 | 25 | 22 | 42 | -85 | 12168 | 11983 | 5.7587103843688965
B_R_1_0.csv | 1 | 1 | 15.0 | 1.1431504832717727 | 1.5937473776754092 | 2.8867786437192793 | 3.3799928461517 | 3.6438152052244206 | 0.2514920075485017 | 4.2268124452568365 | 2.70805020110221 | -60 | -53 | -48 | -47 | 25 | 3 | 49 | -85 | 5215 | 5030 | 2.4950034618377686
B_R_1_0.csv | 2 | 1 | 15.0 | 1.1275989322894642 | 1.6355090698360817 | 3.090936538658643 | 3.5408638991946533 | 4.286315340211186 | 0.41189395672976725 | 4.37708157602443 | 2.70805020110221 | -61 | -51 | -40 | -41 | 49 | 19 | 53 | -85 | 19069 | 18884 | 9.117993354797363
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
