Titaniumthunder/MAC-Attack/model/export/E3_single_accel_a2/vectors/test_recordings.csv

file | cls | label | speed | load | sum_logit_int | ten_T_int | faulty_int8 | score_fp32 | faulty_fp32
B_R_1_0.csv | B_R | 1 | 1 | 0 | 133421 | 52860 | 1 | 9.180323219299316 | 1
B_R_6_0.csv | B_R | 1 | 6 | 0 | 122806 | 52860 | 1 | 8.585922145843506 | 1
F_B_1_0.csv | F_B | 1 | 1 | 0 | 29588 | 52860 | 0 | 2.119820010662079 | 0
F_B_6_0.csv | F_B | 1 | 6 | 0 | 146217 | 52860 | 1 | 10.16051950454712 | 1
H_H_1_0.csv | H_H | 0 | 1 | 0 | -61331 | 52860 | 0 | -4.649159288406372 | 0
H_H_6_0.csv | H_H | 0 | 6 | 0 | -149579 | 52860 | 0 | -10.298965787887573 | 0
K_A_1_0.csv | K_A | 1 | 1 | 0 | 65698 | 52860 | 1 | 4.550071048736572 | 1
K_A_6_0.csv | K_A | 1 | 6 | 0 | 147074 | 52860 | 1 | 10.212368583679199 | 1
R_M_1_0.csv | R_M | 1 | 1 | 0 | 51830 | 52860 | 0 | 3.6813912630081176 | 1
R_M_6_0.csv | R_M | 1 | 6 | 0 | 166390 | 52860 | 1 | 11.468528366088867 | 1
R_U_1_0.csv | R_U | 1 | 1 | 0 | 83635 | 52860 | 1 | 5.80504846572876 | 1
R_U_6_0.csv | R_U | 1 | 6 | 0 | 132059 | 52860 | 1 | 9.101146984100343 | 1
S_W_1_0.csv | S_W | 1 | 1 | 0 | 30871 | 52860 | 0 | 2.087874984741211 | 0
S_W_6_0.csv | S_W | 1 | 6 | 0 | 113691 | 52860 | 1 | 7.781950545310974 | 1
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
