Titaniumthunder/MAC-Attack/model/export/E3_single_accel_a2/vectors/test_windows.csv

file | window | label | f_hz | x0 | x1 | x2 | x3 | x4 | x5 | x6 | x7 | q0 | q1 | q2 | q3 | q4 | q5 | q6 | q7 | C | logit_int | logit_fp32
B_R_1_0.csv | 0 | 1 | 15.0 | 0.21857216614600958 | 0.27262419000178173 | 1.8622078365224488 | 2.4897056992403366 | 4.901707660372534 | -0.30094680816868546 | 4.467234870480621 | 2.70805020110221 | -73 | -73 | -77 | -76 | 7 | -16 | 30 | -93 | 12662 | 12500 | 8.959979057312012
B_R_1_0.csv | 1 | 1 | 15.0 | 0.26239614855781507 | 0.3160830153776373 | 1.9346372768869418 | 2.5367117090349067 | 5.045790147735325 | -0.21297576483904118 | 4.618500225039662 | 2.70805020110221 | -72 | -71 | -73 | -74 | 9 | -7 | 33 | -93 | 12288 | 12126 | 8.491851806640625
B_R_1_0.csv | 2 | 1 | 15.0 | 0.2361527004830409 | 0.29803575674195765 | 2.0364102073230304 | 2.5767170762299667 | 5.6880896326660135 | -0.370051875281624 | 4.920627883284137 | 2.70805020110221 | -73 | -71 | -68 | -72 | 19 | -22 | 39 | -93 | 13990 | 13828 | 9.709562301635742
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
