Titaniumthunder/MAC-Attack/model/results/B01/B01_processed.csv

measurement_id | file | accA_mean | accA_std | accA_rms | accA_peak | accA_p2p | accA_crest | accA_skew | accA_kurt | accA_band_10_1k | accA_band_1k_5k | accA_band_5k_20k | accA_band_20k_64k | accC_mean | accC_std | accC_rms | accC_peak | accC_p2p | accC_crest | accC_skew | accC_kurt | accC_band_10_1k | accC_band_1k_5k | accC_band_5k_20k | accC_band_20k_64k | timestamp | setDyn_N | peakDyn_N | setStat_N | stat_N | setSpeed_rpm | speed_rpm | T1_C | T2_C | Troom_C | gap_before_s | segment | t_in_segment_s | warmup | after_log_end | combined_set_N | flag_setSpeed_out_of_log_range | speed_error_rpm | flag_speed_not_reached | stat_error_N | flag_static_load_off_150N
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
