Titaniumthunder/MAC-Attack/model/results/E3_single_accel_a1/scores.csv

file | cls | label | speed | load | split | score_s42 | faulty_s42 | score_s43 | faulty_s43 | score_s44 | faulty_s44
B_R_1_0.csv | B_R | 1 | 1 | 0 | test | 5.712860822677612 | 1 | 6.250954747200012 | 1 | 6.675328230857849 | 1
B_R_2_0.csv | B_R | 1 | 2 | 0 | val | 10.776861381530761 | 1 | 11.99741439819336 | 1 | 10.638786888122558 | 1
B_R_3_0.csv | B_R | 1 | 3 | 0 | train | 6.8435914516448975 | 1 | 7.201068925857544 | 1 | 8.087876224517823 | 1
B_R_4_0.csv | B_R | 1 | 4 | 0 | train | 7.066466665267944 | 1 | 8.143982219696046 | 1 | 8.891720294952393 | 1
B_R_5_0.csv | B_R | 1 | 5 | 0 | train | 7.626792335510254 | 1 | 8.13188602924347 | 1 | 7.4161771774292 | 1
B_R_6_0.csv | B_R | 1 | 6 | 0 | test | 9.29724316596985 | 1 | 10.827014827728272 | 1 | 9.450406742095947 | 1
B_R_7_0.csv | B_R | 1 | 7 | 0 | val | 7.134873104095459 | 1 | 7.768522810935974 | 1 | 7.321626353263855 | 1
B_R_8_0.csv | B_R | 1 | 8 | 0 | train | 8.599275135993958 | 1 | 9.941710281372071 | 1 | 8.818436670303345 | 1
F_B_1_0.csv | F_B | 1 | 1 | 0 | test | 4.603602766990662 | 1 | 5.391594123840332 | 1 | 4.828370547294616 | 1
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
