Titaniumthunder/MAC-Attack/model/export/E3/vectors/test_recordings.csv

file | cls | label | speed | load | sum_logit_int | ten_T_int | faulty_int8 | score_fp32 | faulty_fp32
B_R_1_0.csv | B_R | 1 | 1 | 0 | 87675 | 17680 | 1 | 5.351388788223266 | 1
B_R_6_0.csv | B_R | 1 | 6 | 0 | 171755 | 17680 | 1 | 10.77358636856079 | 1
F_B_1_0.csv | F_B | 1 | 1 | 0 | 70109 | 17680 | 1 | 4.312144684791565 | 1
F_B_6_0.csv | F_B | 1 | 6 | 0 | 208070 | 17680 | 1 | 13.090977668762207 | 1
H_H_1_0.csv | H_H | 0 | 1 | 0 | -100293 | 17680 | 0 | -27.06829423904419 | 0
H_H_6_0.csv | H_H | 0 | 6 | 0 | -170895 | 17680 | 0 | -10.713207912445068 | 0
K_A_1_0.csv | K_A | 1 | 1 | 0 | 43194 | 17680 | 1 | 2.4945566236972807 | 1
K_A_6_0.csv | K_A | 1 | 6 | 0 | 211785 | 17680 | 1 | 13.214746475219727 | 1
R_M_1_0.csv | R_M | 1 | 1 | 0 | 88154 | 17680 | 1 | 5.454849600791931 | 1
R_M_6_0.csv | R_M | 1 | 6 | 0 | 212924 | 17680 | 1 | 13.369652032852173 | 1
R_U_1_0.csv | R_U | 1 | 1 | 0 | 90191 | 17680 | 1 | 5.586092448234558 | 1
R_U_6_0.csv | R_U | 1 | 6 | 0 | 187914 | 17680 | 1 | 11.842382526397705 | 1
S_W_1_0.csv | S_W | 1 | 1 | 0 | 100044 | 17680 | 1 | 6.188697004318238 | 1
S_W_6_0.csv | S_W | 1 | 6 | 0 | 186114 | 17680 | 1 | 11.686814165115356 | 1
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
