Titaniumthunder/MAC-Attack/model/export/E3/vectors/test_windows.csv

file | window | label | f_hz | x0 | x1 | x2 | x3 | x4 | x5 | x6 | x7 | x8 | x9 | x10 | x11 | x12 | x13 | x14 | x15 | x16 | x17 | x18 | x19 | x20 | x21 | q0 | q1 | q2 | q3 | q4 | q5 | q6 | q7 | q8 | q9 | q10 | q11 | q12 | q13 | q14 | q15 | q16 | q17 | q18 | q19 | q20 | q21 | C | logit_int | logit_fp32
B_R_1_0.csv | 0 | 1 | 15.0 | 1.1031255903723058 | 1.5277983264469033 | 2.8217980247489423 | 3.3024169106901375 | 3.6473457026598424 | 0.4415891384384792 | 3.963131535914407 | 0.21857216614600958 | 0.27262419000178173 | 1.8622078365224488 | 2.4897056992403366 | 4.901707660372534 | -0.30094680816868546 | 4.467234870480621 | 0.15050192659454564 | 0.16505556041228914 | 2.818679174034428 | 3.322382286830204 | 14.205420450300883 | -0.1685209080323934 | 5.530738065815215 | 2.70805020110221 | -51 | -45 | -41 | -41 | 20 | 18 | 34 | -55 | -54 | -58 | -57 | 5 | -12 | 23 | -51 | -50 | -20 | -24 | 88 | -13 | 35 | -70 | 12561 | 12441 | 7.673015117645264
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
