Titaniumthunder/MAC-Attack/model/results/E0/scores.csv

file | cls | label | speed | load | split | score_s42 | faulty_s42 | score_s43 | faulty_s43 | score_s44 | faulty_s44
B_R_1_0.csv | B_R | 1 | 1 | 0 | test | -1.9829341173171997 | 1 | -1.1063721179962158 | 0 | -2.359797716140747 | 0
B_R_2_0.csv | B_R | 1 | 2 | 0 | val | 4.448419094085693 | 1 | -0.17559924721717834 | 1 | 2.629284620285034 | 1
B_R_3_0.csv | B_R | 1 | 3 | 0 | train | 2.64133882522583 | 1 | 0.08179114758968353 | 1 | 2.018758773803711 | 1
B_R_4_0.csv | B_R | 1 | 4 | 0 | train | 3.121448516845703 | 1 | 0.20159655809402466 | 1 | 4.412953853607178 | 1
B_R_5_0.csv | B_R | 1 | 5 | 0 | train | 2.0045440196990967 | 1 | -0.360294908285141 | 1 | 1.6218326091766357 | 1
B_R_6_0.csv | B_R | 1 | 6 | 0 | test | 1.5338534116744995 | 1 | -0.003281891345977783 | 1 | 1.9620939493179321 | 1
B_R_7_0.csv | B_R | 1 | 7 | 0 | val | 1.5759862661361694 | 1 | -0.3700319230556488 | 1 | 1.605880856513977 | 1
B_R_8_0.csv | B_R | 1 | 8 | 0 | train | 1.3671441078186035 | 1 | -0.048074014484882355 | 1 | 1.3396939039230347 | 1
F_B_1_0.csv | F_B | 1 | 1 | 0 | test | -3.0569276809692383 | 0 | -1.214625597000122 | 0 | -2.9109065532684326 | 0
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
