Titaniumthunder/MAC-Attack/model/results/E1/scores.csv

file | cls | label | speed | load | split | score_s42 | faulty_s42 | score_s43 | faulty_s43 | score_s44 | faulty_s44
B_R_1_0.csv | B_R | 1 | 1 | 0 | test | -1.927597999572754 | 0 | -1.9518585205078125 | 0 | -2.236776351928711 | 0
B_R_2_0.csv | B_R | 1 | 2 | 0 | val | 4.846927642822266 | 1 | 4.581917762756348 | 1 | 2.0843348503112793 | 1
B_R_3_0.csv | B_R | 1 | 3 | 0 | train | 2.154175281524658 | 1 | 1.6846885681152344 | 1 | 1.7206588983535767 | 1
B_R_4_0.csv | B_R | 1 | 4 | 0 | train | 3.366187810897827 | 1 | 3.2551236152648926 | 1 | 2.5759682655334473 | 1
B_R_5_0.csv | B_R | 1 | 5 | 0 | train | 1.503165364265442 | 1 | 1.6859420537948608 | 1 | 1.0743709802627563 | 1
B_R_6_0.csv | B_R | 1 | 6 | 0 | test | 2.2554290294647217 | 1 | 2.918489933013916 | 1 | 2.1708922386169434 | 1
B_R_7_0.csv | B_R | 1 | 7 | 0 | val | 1.5728524923324585 | 1 | 1.960205316543579 | 1 | 1.0399842262268066 | 1
B_R_8_0.csv | B_R | 1 | 8 | 0 | train | 1.8766440153121948 | 1 | 2.3041858673095703 | 1 | 1.2958800792694092 | 1
F_B_1_0.csv | F_B | 1 | 1 | 0 | test | -3.3397481441497803 | 0 | -3.240915298461914 | 0 | -3.361295700073242 | 0
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
