Titaniumthunder/MAC-Attack/model/results/E2/scores.csv

file | cls | label | speed | load | split | score_s42 | faulty_s42 | score_s43 | faulty_s43 | score_s44 | faulty_s44
B_R_1_0.csv | B_R | 1 | 1 | 0 | test | 8.232442712783813 | 1 | -1.5944758415222169 | 0 | 9.53573136329651 | 1
B_R_2_0.csv | B_R | 1 | 2 | 0 | val | 16.819236946105956 | 1 | 3.3621355295181274 | 1 | 13.458084011077881 | 1
B_R_3_0.csv | B_R | 1 | 3 | 0 | train | 9.721174430847167 | 1 | 2.387336587905884 | 1 | 10.149759483337402 | 1
B_R_4_0.csv | B_R | 1 | 4 | 0 | train | 10.455389499664307 | 1 | 3.626648020744324 | 1 | 10.420472335815429 | 1
B_R_5_0.csv | B_R | 1 | 5 | 0 | train | 11.231356763839722 | 1 | 1.415606501698494 | 1 | 9.757098150253295 | 1
B_R_6_0.csv | B_R | 1 | 6 | 0 | test | 8.808620023727418 | 1 | 2.2589473009109495 | 1 | 8.462461376190186 | 1
B_R_7_0.csv | B_R | 1 | 7 | 0 | val | 11.142282009124756 | 1 | 1.1855117678642273 | 1 | 9.910580253601074 | 1
B_R_8_0.csv | B_R | 1 | 8 | 0 | train | 9.538955926895142 | 1 | 2.3110876083374023 | 1 | 9.086680698394776 | 1
F_B_1_0.csv | F_B | 1 | 1 | 0 | test | 3.990898048877716 | 0 | -0.8406834989786148 | 0 | 5.091514539718628 | 0
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
