Titaniumthunder/MAC-Attack/model/results/E3/scores.csv

file | cls | label | speed | load | split | score_s42 | faulty_s42 | score_s43 | faulty_s43 | score_s44 | faulty_s44
B_R_1_0.csv | B_R | 1 | 1 | 0 | test | 5.351388788223266 | 1 | 6.670730447769165 | 1 | 5.443294024467468 | 1
B_R_2_0.csv | B_R | 1 | 2 | 0 | val | 17.83782329559326 | 1 | 17.367916107177734 | 1 | 14.069211864471436 | 1
B_R_3_0.csv | B_R | 1 | 3 | 0 | train | 9.463726234436034 | 1 | 11.849386405944824 | 1 | 7.710060930252075 | 1
B_R_4_0.csv | B_R | 1 | 4 | 0 | train | 10.207422065734864 | 1 | 11.09341812133789 | 1 | 7.896360540390015 | 1
B_R_5_0.csv | B_R | 1 | 5 | 0 | train | 11.355805444717408 | 1 | 11.134486818313599 | 1 | 9.286123371124267 | 1
B_R_6_0.csv | B_R | 1 | 6 | 0 | test | 10.77358636856079 | 1 | 10.733428382873536 | 1 | 8.793924474716187 | 1
B_R_7_0.csv | B_R | 1 | 7 | 0 | val | 10.626963877677918 | 1 | 10.449492120742798 | 1 | 8.818052673339844 | 1
B_R_8_0.csv | B_R | 1 | 8 | 0 | train | 10.851570320129394 | 1 | 11.162610578536988 | 1 | 9.133188486099243 | 1
F_B_1_0.csv | F_B | 1 | 1 | 0 | test | 4.312144684791565 | 1 | 3.2159242928028107 | 1 | 4.864407706260681 | 1
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
