Titaniumthunder/MAC-Attack/model/report/figures/seeds_test.png

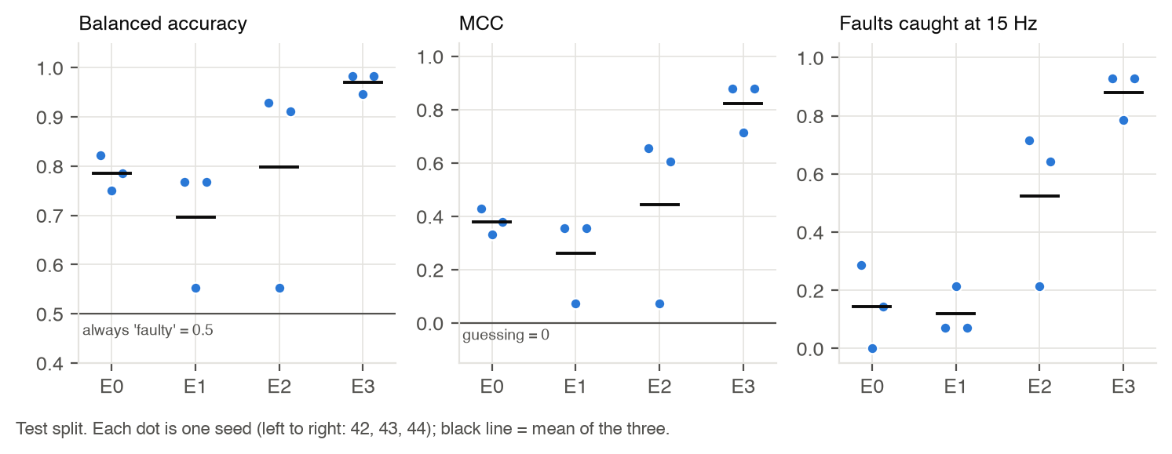
model/report/figures/seeds_test.png
