Titaniumthunder/MAC-Attack/model/results/B01/figures/B01_normalized_residuals.png

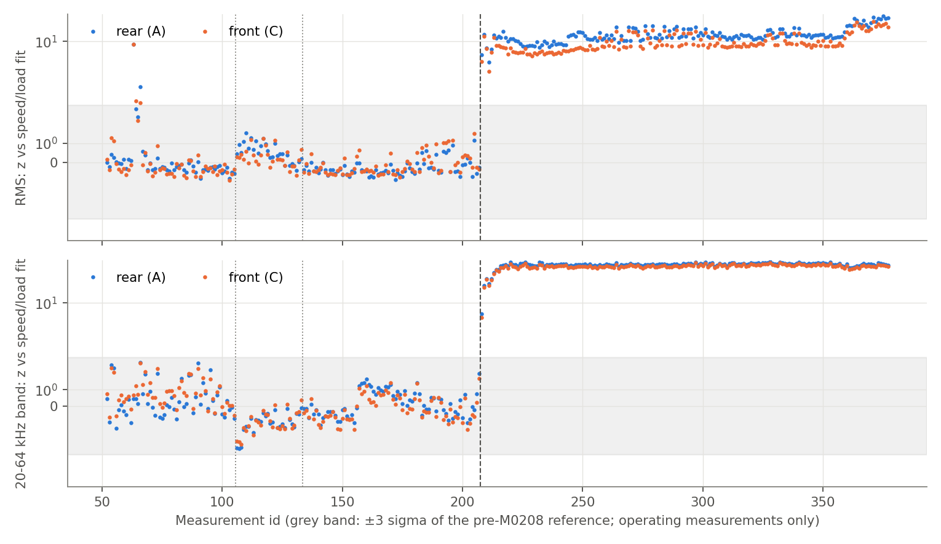
model/results/B01/figures/B01_normalized_residuals.png
