Titaniumthunder/MAC-Attack/model/results/B01/figures/B01_temperature_effect.png

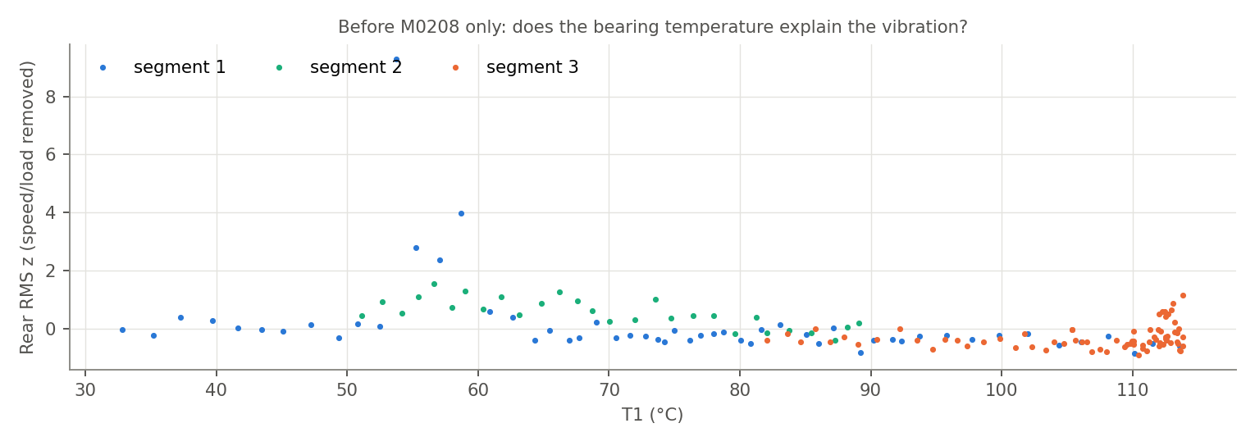
model/results/B01/figures/B01_temperature_effect.png
