Titaniumthunder/MAC-Attack/model/results/B01/figures/B01_vibration_features.png

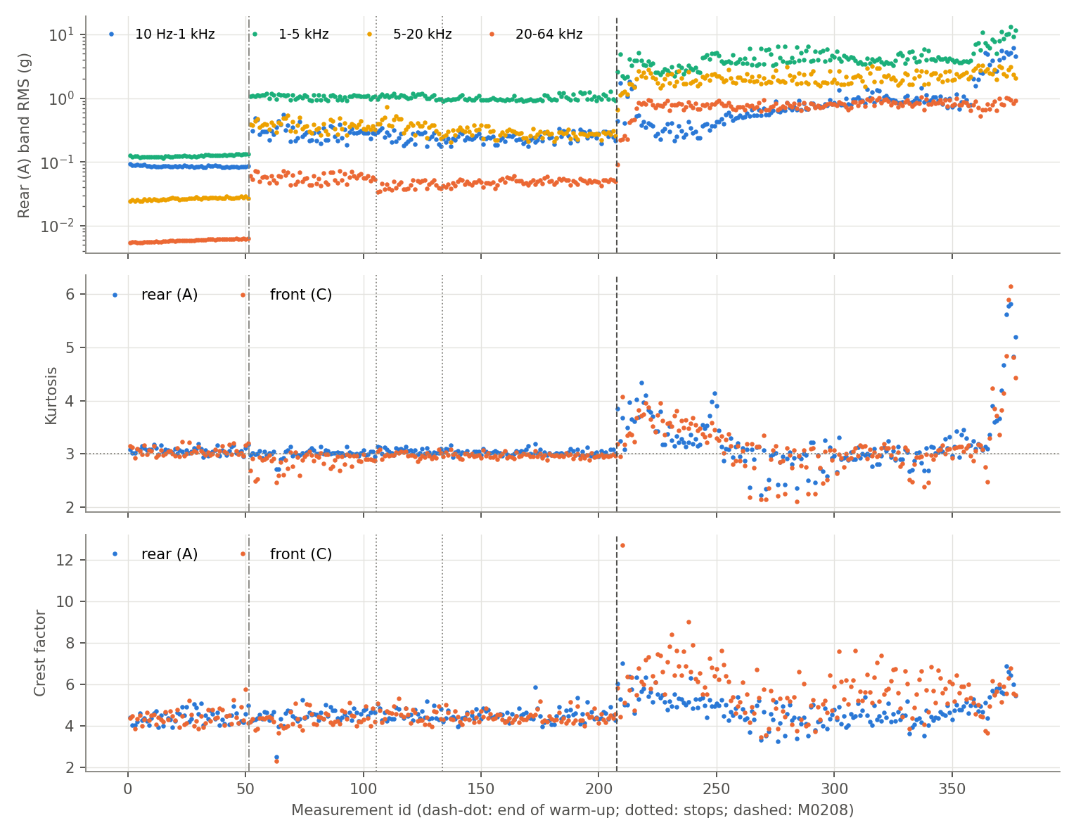
model/results/B01/figures/B01_vibration_features.png
