Titaniumthunder/MAC-Attack/model/results/B01/figures/B01_vibration_vs_speed.png

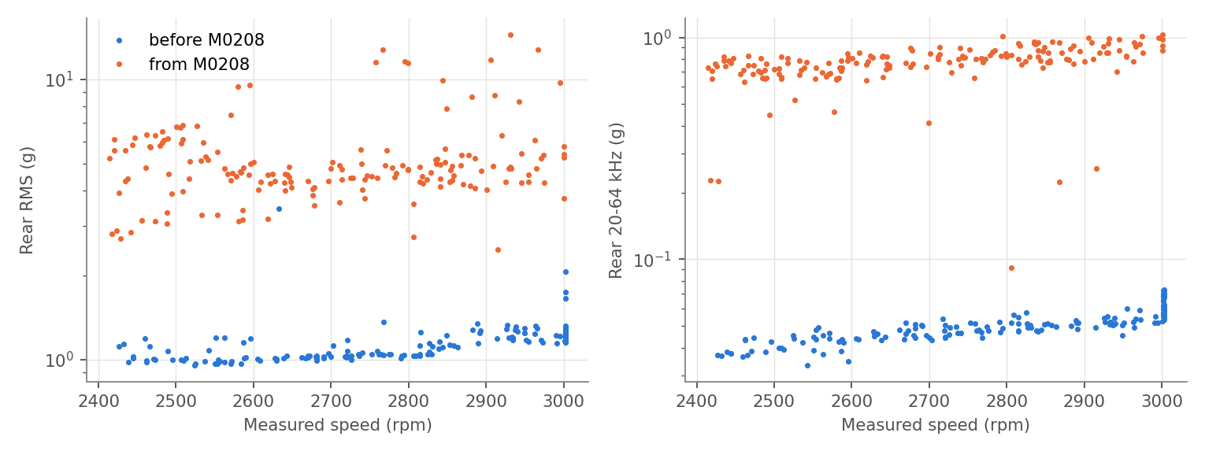
model/results/B01/figures/B01_vibration_vs_speed.png
