Titaniumthunder/MAC-Attack/model/results/ramps/ramps.png

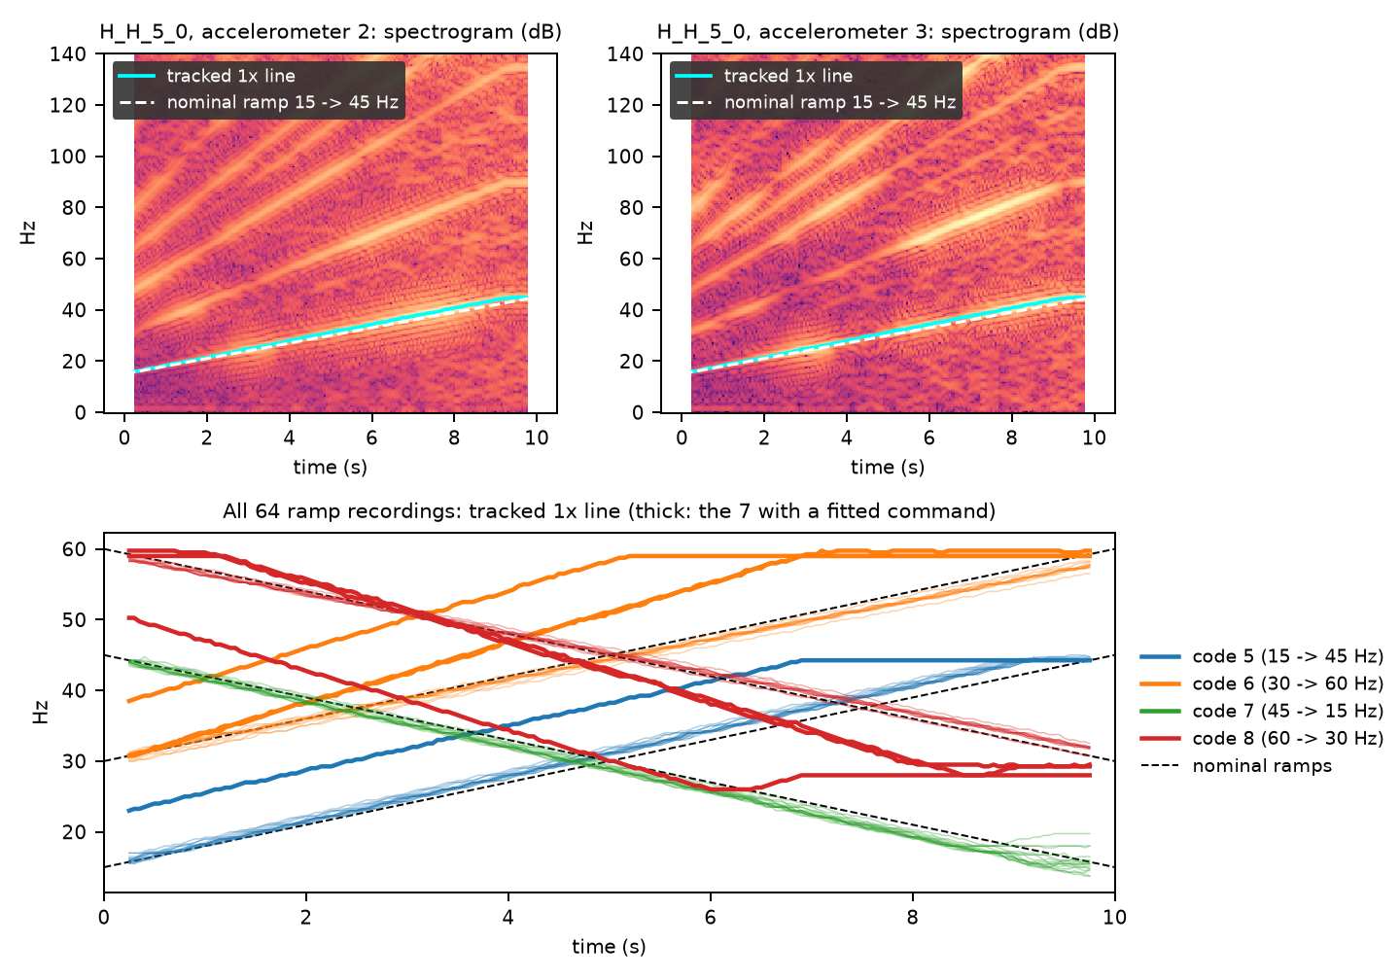
model/results/ramps/ramps.png
