Titaniumthunder/MAC-Attack/model/results/supervised/run3/analysis/figures/scores_B_wd_run3.png

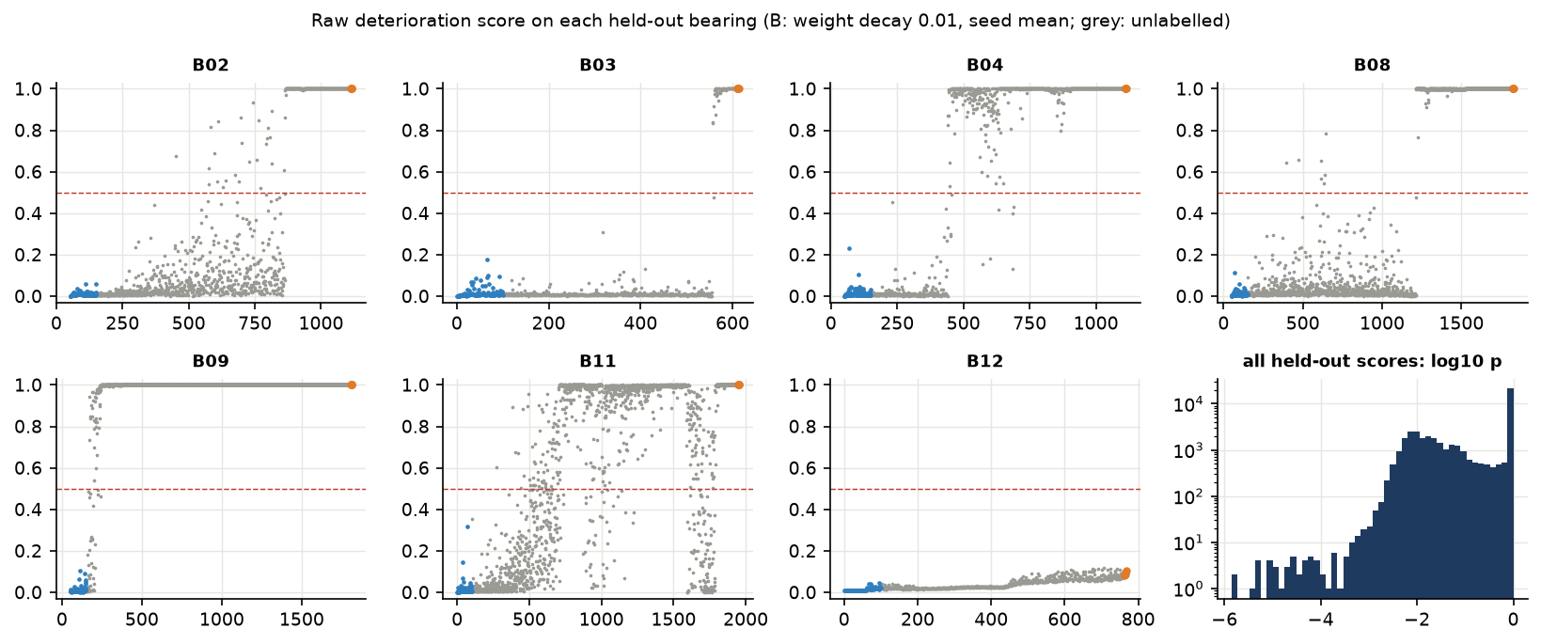
model/results/supervised/run3/analysis/figures/scores_B_wd_run3.png
