Titaniumthunder/MAC-Attack/modelV2/runs/20261110-220018_A_severity_onset/history.csv

step | lr | fold | seed | train_status | train_health | val_status_pad | val_status_ott | val_acc_pad | val_acc_ott | val_health | val_mae
0 | 0.001 | B02 | 0 |  |  | 1.1918327808380127 |  | 0.0 | 0.0 | 0.2432403564453125 | 52.4132080078125
0 | 0.001 | B02 | 1 |  |  | 1.1383925676345825 |  | 0.0 | 0.4038461446762085 | 0.22797325253486633 | 47.22848129272461
0 | 0.001 | B02 | 2 |  |  | 1.0841281414031982 |  | 0.11764705926179886 | 0.42307692766189575 | 0.22930078208446503 | 47.78884506225586
0 | 0.001 | B03 | 0 |  |  | 1.1785738468170166 |  | 0.0 | 0.0 | 0.22852377593517303 | 53.39775848388672
0 | 0.001 | B03 | 1 |  |  | 1.1463139057159424 |  | 0.0 | 0.5641025900840759 | 0.20858551561832428 | 45.57648468017578
0 | 0.001 | B03 | 2 |  |  | 1.1015877723693848 |  | 0.11764705926179886 | 0.42307692766189575 | 0.21546635031700134 | 47.756839752197266
0 | 0.001 | B04 | 0 |  |  | 1.179718017578125 |  | 0.0 | 0.0 | 0.211994931101799 | 41.64644241333008
0 | 0.001 | B04 | 1 |  |  | 1.137037754058838 |  | 0.0 | 0.42307692766189575 | 0.19333527982234955 | 43.04747772216797
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
