Titaniumthunder/MAC-Attack/(commit log)

2026-10-15 Add 01_small_numbers_A.csv with small number vectors
    [01_small_numbers_A.csv]
2026-10-16 Track mac_zed_project: Vivado project, design sources, and SDK app code
    Stop ignoring mac_zed_project/ wholesale. Build outputs (.cache, .runs, .sim, BSPs, hw platforms, SDK .metadata) stay ignored.
2026-10-20 Add OpenLane 2 TPU metrics and reports
    [metrics.csv]
2026-10-28 Machine Guardian model: E0-E3, health index, INT8 export, RTL check, report
    - model/: features of the 128 Ottawa motor recordings (no dataset needed to
    train or export), experiments E0 (James's baseline) to E3, the health index
    H1 (output 2), the INT8 export of E3 seed 42 (hex files for tb_mlp.sv,
    mg_model.h, test vectors), rtl_check.py (Icarus) and the PDF report.
    - E3 seed 42 (proposed, Alex to confirm): test 27/28 faults found, 0/4 false
    alarms, ROC-AUC 1.000; INT8 changes no 10-s decision; on the RTL every logit
    is bit-exact, 566 cycles (2.64 us) per 1-s window at 214.286 MHz.
    - docs/log.md section 12: every decision and result, with the limits (one
    healthy motor, 4 healthy t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
    [health.csv, recordings.csv, scores.csv, speed.csv, test_recordings.csv, test_windows.csv, tracks.csv, windows.csv]
2026-11-03 Train the deterioration head: runs 1 and 2, dashboard, reports
    - Remove the two-person label sign-off from supervised_prep.ready() at the
    team's request (all other data and label-integrity checks kept); tests updated.
    - train_deterioration.py: live progress.json and a training figure (training
    itself unchanged); training_dashboard.html shows the run in a browser.
    - Run 1: 3 leave-one-bearing-out folds (B02-B04) x 3 seeds.
    - Run 2 (train_deterioration_run2.py): latched alarm, comparison with the
    anomaly detector, calibration study, temperature-input check, regularisation
    diagnostics, INT8 and RTL check of the trained networks. Networks are
    byte-identical to Run 1; Run 1 files verifi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
    [checkpoints.csv, predictions_B02.csv, predictions_B03.csv, predictions_B04.csv, variants.csv]
2026-11-03 Add Paderborn bearings B08, B09, B11, B12 and training run 3
    Data
    - extract_paderborn_zips.py: verified extraction (member paths, CRC-32, SHA-256
    manifests; ZIP64 B08.zip; B09 parts merged) into model/newdata/ (not in git).
    - paderborn.py: accept 5-digit measurement ids (data_B09_M00001.mat); B01-B04
    results unchanged.
    - paderborn_experiments.json: B08, B09, B11, B12 logs transcribed (previous
    version kept in results/supervised/run3/provenance/).
    - results/paderborn/B08-B12: processed data, checks, manifests, overviews.
    Run 3 (results/supervised/run3/)
    - run3_prep.py: 7 labelled bearings, label table (B01-B04 part reproduces the
    Run 1-2 hash), raw and clipped inputs, data-quality re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
    [B08_processed.csv, B09_processed.csv, B11_processed.csv, B12_processed.csv, curves.csv, dataset_B02.csv, dataset_B03.csv, dataset_B04.csv]
2026-11-03 Step 16: SKY130 SRAM macros for mm_core's buffers (ASIC option)
    - rtl/sram_buf.sv (new): a W x D buffer built from sky130_sram_2kbyte_1rw1r_32x512_8
    macros (port 0 writes, port 1 reads; read data one clock after the address,
    like the FPGA block RAMs, so no cycle count changes).
    - mm_core.sv: parameter SRAM = 1 builds the A, B and C buffers from sram_buf
    (OpenLane infers no RAM: with SRAM = 0 every buffer bit became a flip-flop).
    SRAM = 0 (default) is the design exactly as before, for the FPGA.
    - mlp_ctrl.sv, tb_mm.sv, tb_mlp.sv: pass SRAM through; tb_mm samples rd_data at
    the clock edge as the hardware would.
    - mac.py: --sram option, builds tb_mm and tb_mlp with SRAM = 1 and the PD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
    [mac.py, mlp_ctrl.sv, mm_core.sv, sram_buf.sv, tb_mlp.sv, tb_mm.sv]
2026-11-06 Archive the 13 Oct zed/mac_test.c copies of both designs
    git mv only (same content in both). The current board program is each design's SDK app, mac_zed_project/mac_zed.sdk/MAC_attack_V2/src/mac_test.c; the READMEs and the log's open question now point there. No Tcl, .xpr or script used the old copies.
2026-11-06 README: fix stale claims (tracked projects rule, MLP clock, task, rebuild warning)
    Rule 2 now describes what .gitignore and the 18 Oct decision track. Design 2 row: step 15c, FCLK asked 225 / actual 214.286 MHz, register slice. Application: Ottawa motor vibration (27 Oct decision), not machine sound / DCASE. Rebuild note: create_zed_project.tcl uses -force (deletes the tracked project) and FCLK_MHZ 200. BSP note per design. Adds model/ and archive/ to the folder map.
2026-11-06 log.md: mark two-clock mode as never built, add build status to old headings, fix stale numbers and paths
    Notes only, history kept: step 12 (two clocks) written and simulated, never built or run on the board (sections 2, 5, 9); a 5 Nov row clarifies the 21 Oct 'waits for a faster board' decision; 'not built' headings of steps 11, 11b, 13, 14, 15, 15b, 15c say when they were built; step 15c model clocks next to the step 15 table; perf_total +7 since step 10b/11; tb_axi counts; paths (mlp_ctrl.sv in mac_attack_accel_MLP, docs/Machine_Guardian_model_report.pdf); try_250MHz; first-rtl-results.md marked TODO; 15d clock-converter idea vs CORE_CLK = 1.
2026-11-06 Design READMEs: current build status, 8x8/22-bit ZedBoard caveat, perf_total +5
    Status rows: design 1 tb_axi 14/14, built at 250 MHz, board 24/24 (19 Oct); design 2 tb_axi 20/20, SDK program 30/30 against the RTL, built at 214.286 MHz, board run TODO (on Alex_edit only). 16x16 / 32-bit is chip_top; the ZedBoard build is P = 8 with 22-bit sums. tb_selfcheck perf_total is +5 (mm_core defaults PIPE = 1, MEM_REG = 1). Arty status marked TODO (conflicts with zed/README.md). Design 2 paths say C:\mac_attack_accel_MLP.
2026-11-06 Design 2 zed/README: 214.286 MHz build, 21 registers, 22-bit sums, 20/20 and 30/30, register slice
    FCLK_CLK0 asked 225, actual 214.285706 MHz (ps7 xci); diagram and GUI steps add mac_rs, mlp_ctrl and the core_locked constant; register map: STATUS bit 3, CONFIG bit 16 and PARAM_DATA caveats (two-clock mode never built, builds without the MLP); this project tracks no .hdf/platform/BSP yet (TODO Alex: export hardware); create_zed_project.tcl rebuilds at 200 MHz; 2019.1 .hdf/SDK flow note; 13 Oct console numbers marked history/TODO; board results TODO (only on Alex_edit).
2026-11-06 Design 1 zed/README: 250 MHz build, 13 registers with CONFIG, 22-bit sums, 14/14 and 24/24
    FCLK_CLK0 250.000 MHz (ps7 xci); status now step 14 (built, WNS +0.008 ns, board 24/24 on 19 Oct); register map adds 0x30 CONFIG and STATUS bit 3 (two-clock mode never built); PERF_TOTAL +7; create_zed_project.tcl rebuilds at 200 MHz; 2019.1 .hdf/SDK flow note; 13 Oct console numbers marked history/TODO.
2026-11-09 Design 2 cleanup: restore Vivado project, remove two-clock and Arty files
    - Restore mac_attack_accel_MLP/zed/mac_zed_project to its state before
    d705c79: that commit carried Vivado side effects (block design no longer
    validated, system_mac_0 IP outputs and hw_handoff deleted).
    - Remove the two-clock option from the build: zed/mac_zed_cdc.xdc and the
    CORE_MHZ / Clocking Wizard branch in create_zed_project.tcl (never built;
    the board runs one clock). The RTL parameters stay for now.
    - Remove the Arty A7 files from design 2 (fpga/, vivado/create_project.tcl,
    tb_compare, tb_extras, tb_selfcheck) and its openlane/ copy (identical to
    design 1's, which stays).
    - Remove CLEANUP_PLAN.md (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
    [mac_attack_chip.sv, mac_axi.v, system.v, system_mac_0.v]
2026-11-11 modelV2: frozen bearing-health model (13-32-16-4, INT8) and its ZedBoard test app
    modelV2/ is a new model for the MAC accelerator's on-chip MLP, trained on
    Paderborn and checked against Ottawa (UORED-VAFCLS). model/ and the RTL are
    unchanged.
    - Code: feature pipeline, prep, pre-checks, training, evaluation, INT8 export,
    freeze, one-time locked test, report and live inference.
    - Results: six training runs with their exports, the frozen model
    (20261110-220018_A_severity_onset, seed 0), the locked-bearing results and
    report.html / report.pdf.
    - MAC_model_V2: SDK application that loads the frozen model into the chip and
    checks 64 test rows against the golden sums. Passes against mac_axi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
    [history.csv]
2026-11-11 clean up model
    [history.csv]
2026-11-12 MAC_model_V2: run the model on the ARM alone, print speedup, fix weight count
    - model_sw() runs the three layers in software with the chip's rounding; its
    256 sums are checked as a fourth test and its time is the baseline for a
    speedup line after each accelerator test.
    - The program printed 1,088 weights; the model has 992 weights and 52 biases.
    Compiled on a PC at -O0 and -O2 without warnings; the register accesses are
    unchanged from the sequence replayed on mac_axi in simulation. Not built in
    the SDK or run on the board.
2026-11-12 Organize model documents into docs/Model and add the modelV2 review
    Every model document now sits in docs/Model, numbered 01-14 in the order the
    work happened (builds on the unmerged 9 Nov reorganisation on MLmodel):
    - 00_Current_model (Run 3 summary) becomes 12_Run3_model_summary, marked as
    superseded by modelV2; its builder is make_run3_summary_report.py.
    - modelV2's report PDF becomes 13_modelV2_bearing_status_and_health.pdf;
    modelV2/report.py now writes it there.
    - model/SINGLE_ACCEL_*.md move to docs/Model/supporting_single_accel/02a-02c.
    - New 14_modelV2_review_session.pdf: modelV2 run on a PC (B03 replay,
    bit-exact, RTL on xsim), accuracy/precision/recall/F1, health-index error,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
    [dev_report_figures.py, make_b01_report.py, make_dev_report_v2.py, make_label_review_report.py, make_multitask_report.py, make_paderborn_baseline_report.py, make_phase2_report.py, make_report.py]
