Titaniumthunder/MAC-Attack/(notices)

Notices in the files:
mac_attack_accel/zed/mac_zed_project/mac_zed.srcs/sources_1/bd/system/ip/system_ps7_0/hdl/verilog/processing_system7_v5_5_processing_system7.v:
This file contains proprietary and confidential information of
Xilinx, Inc. ("Xilinx"), that is distributed under a license
Copyright 2010 Xilinx, Inc.
All rights reserved.
